designmaster0928/Bluetooth-Adapter-Project/K-cord_Pinouts.png

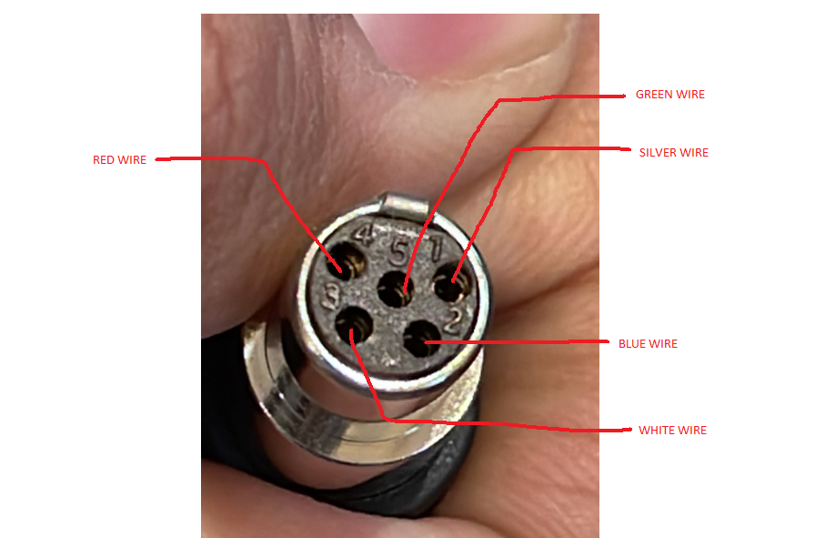
K-cord_Pinouts.png
