designmaster0928/Bluetooth-Adapter-Project/Photo/DA726437-B9D8-48D1-A68D-65F9451EB42A.jpg

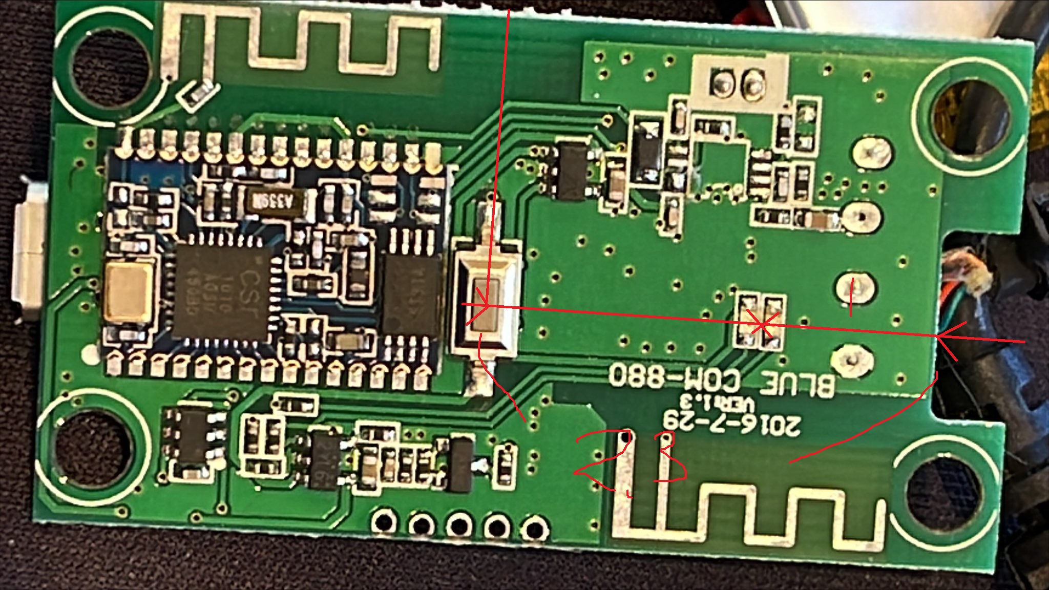
Photo/DA726437-B9D8-48D1-A68D-65F9451EB42A.jpg
