designmaster0928/Bluetooth-Adapter-Project/BLUETOOTH ADAPTER CASE-SW/Skype_Picture_2023_05_28T19_03_59_601Z.jpeg

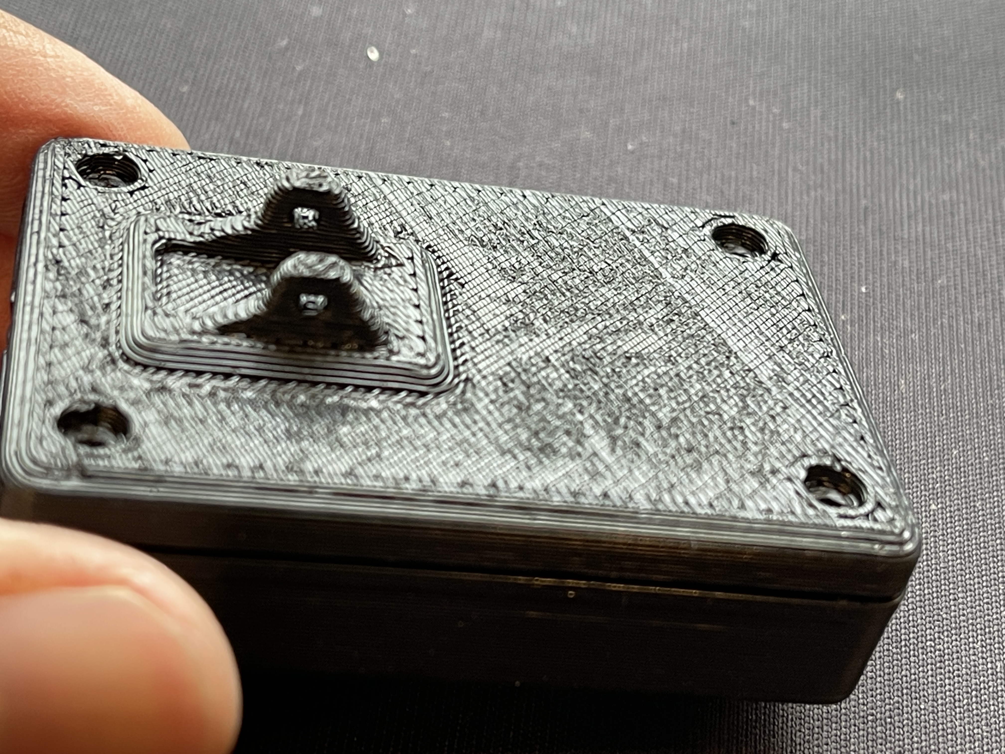
BLUETOOTH ADAPTER CASE-SW/Skype_Picture_2023_05_28T19_03_59_601Z.jpeg
