designmaster0928/Bluetooth-Adapter-Project/BLUETOOTH ADAPTER CASE-SW/Skype_Picture_2023_05_28T19_04_05_961Z.jpeg

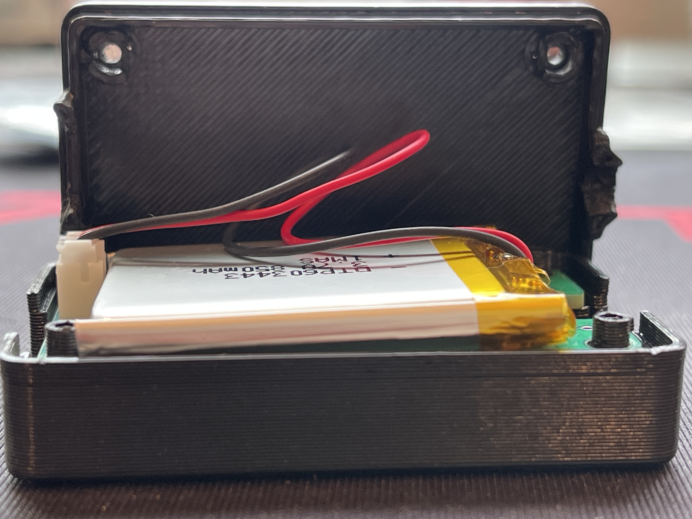
BLUETOOTH ADAPTER CASE-SW/Skype_Picture_2023_05_28T19_04_05_961Z.jpeg
