designmaster0928/Bluetooth-Adapter-Project/DC9E3603-5C23-4AAF-9660-845D350AA5AE.jpg

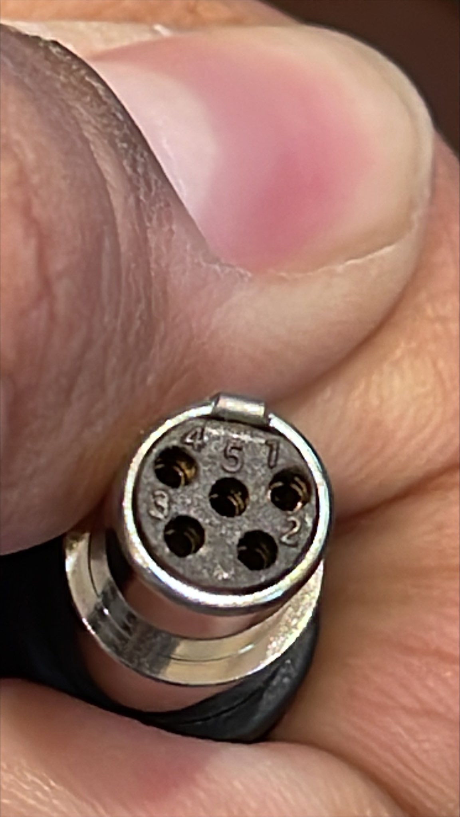
DC9E3603-5C23-4AAF-9660-845D350AA5AE.jpg
