designmaster0928/Bluetooth-Adapter-Project/Photo/6621D68A-7FBE-48DB-8DF5-E619D0314C2F.jpg

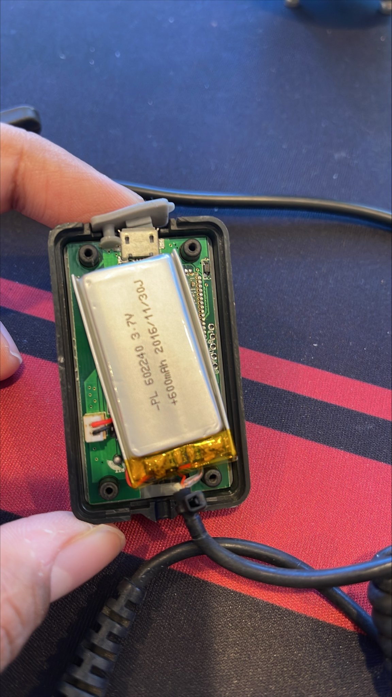
Photo/6621D68A-7FBE-48DB-8DF5-E619D0314C2F.jpg
