designmaster0928/Bluetooth-Adapter-Project/Photo/C3E56E78-954D-4BAD-87F1-18FE880F4F31.jpg

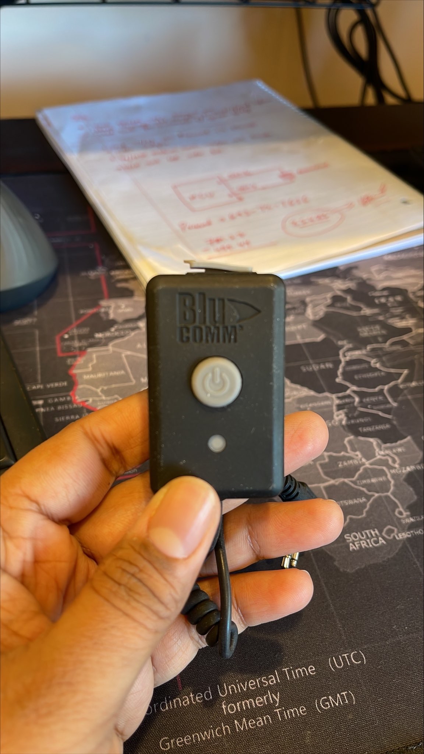
Photo/C3E56E78-954D-4BAD-87F1-18FE880F4F31.jpg
