designmaster0928/Bluetooth-Adapter-Project/Photo/C45BCC9A-C9F5-43B7-A155-E445F8E02B1C.jpg

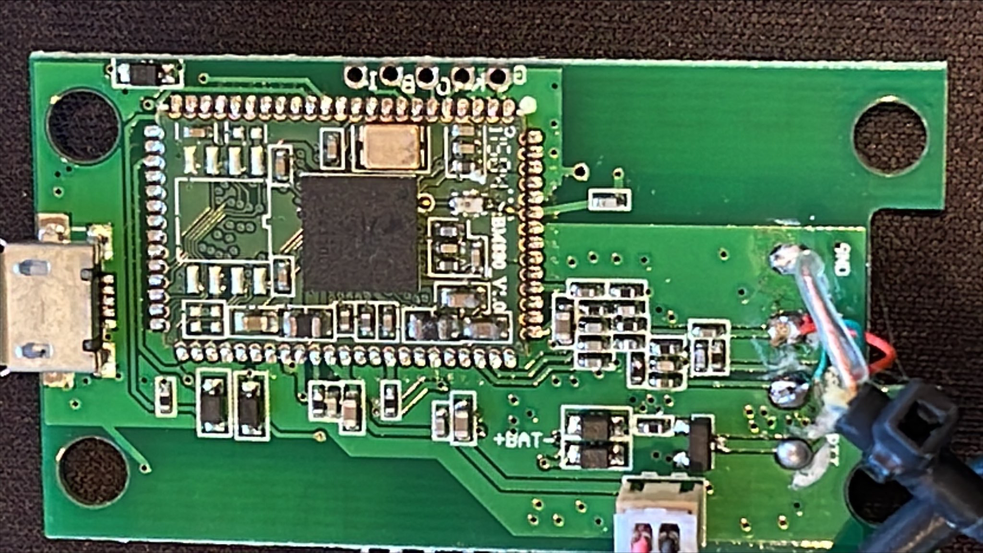
Photo/C45BCC9A-C9F5-43B7-A155-E445F8E02B1C.jpg
