designmaster0928/Bluetooth-Adapter-Project/Photo/C2696927-9B45-439D-AC03-30553FDB2B25.jpg

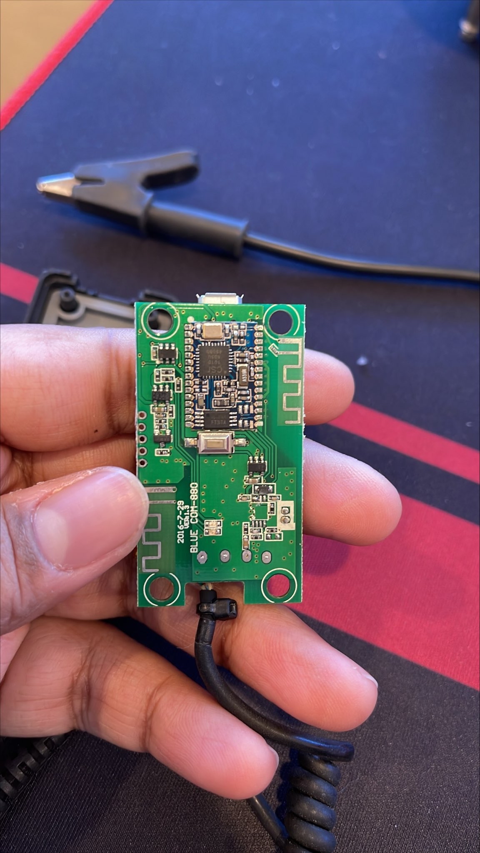
Photo/C2696927-9B45-439D-AC03-30553FDB2B25.jpg
