designmaster0928/Bluetooth-Adapter-Project/Photo/EB455BE9-71F3-468A-BE8D-6DA9E513DC0C.jpg

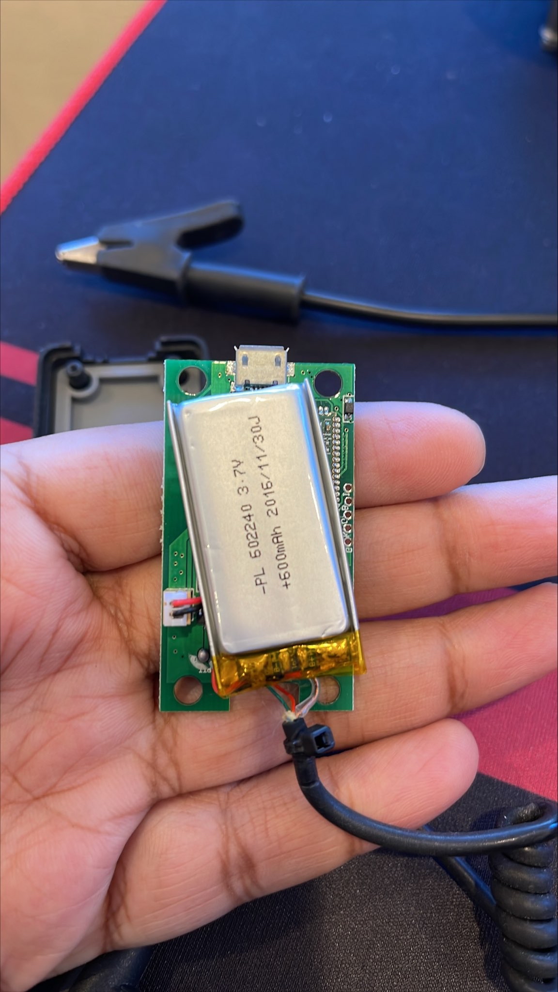
Photo/EB455BE9-71F3-468A-BE8D-6DA9E513DC0C.jpg
