designmaster0928/Bluetooth-Adapter-Project/Photo/image_2023_01_27T21_55_18_105Z.png

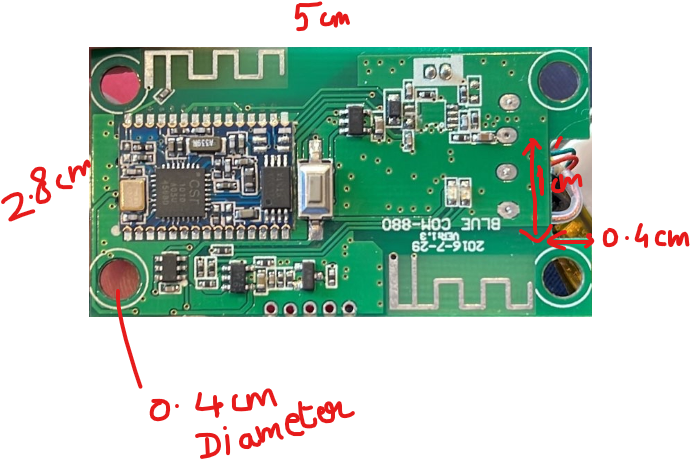
Photo/image_2023_01_27T21_55_18_105Z.png
