designmaster0928/Bluetooth-Adapter-Project/Photo/image_2023_01_27T21_58_32_056Z.png

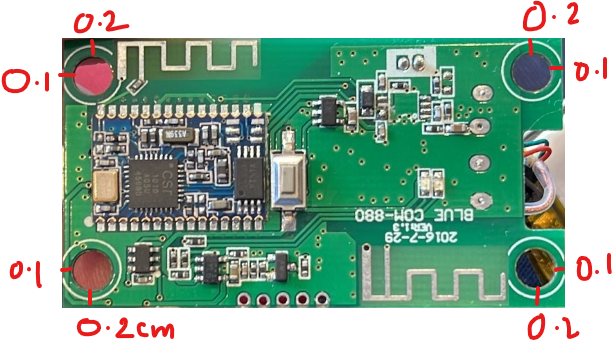
Photo/image_2023_01_27T21_58_32_056Z.png
