designmaster0928/Bluetooth-Adapter-Project/Photo/k-cord1.PNG

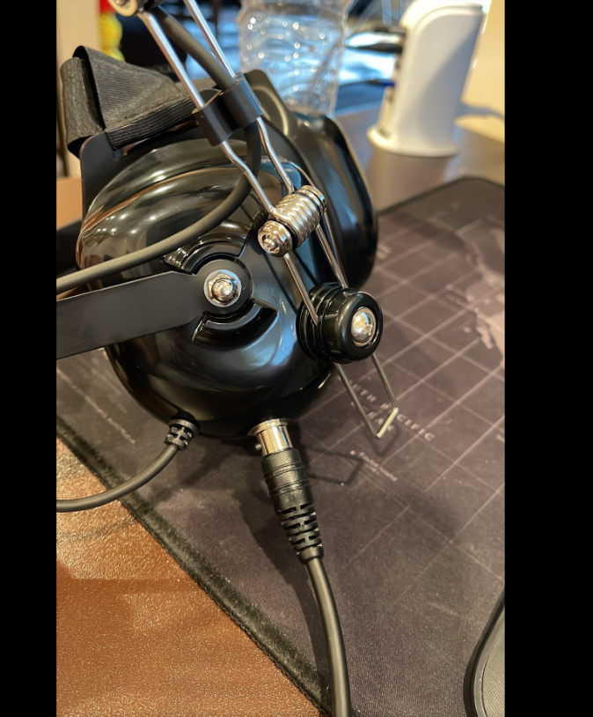
Photo/k-cord1.PNG
