designmaster0928/Bluetooth-Adapter-Project/Photo/k-cord2.PNG

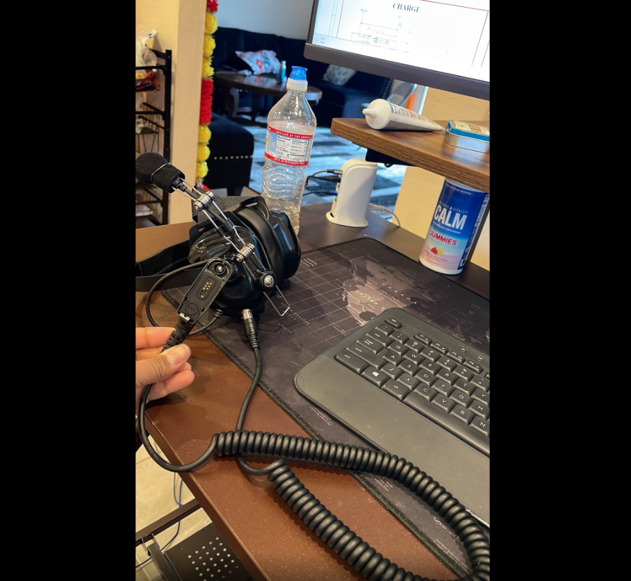
Photo/k-cord2.PNG
