designmaster0928/Bluetooth-Adapter-Project/Photo/k-cord-incablewire.PNG

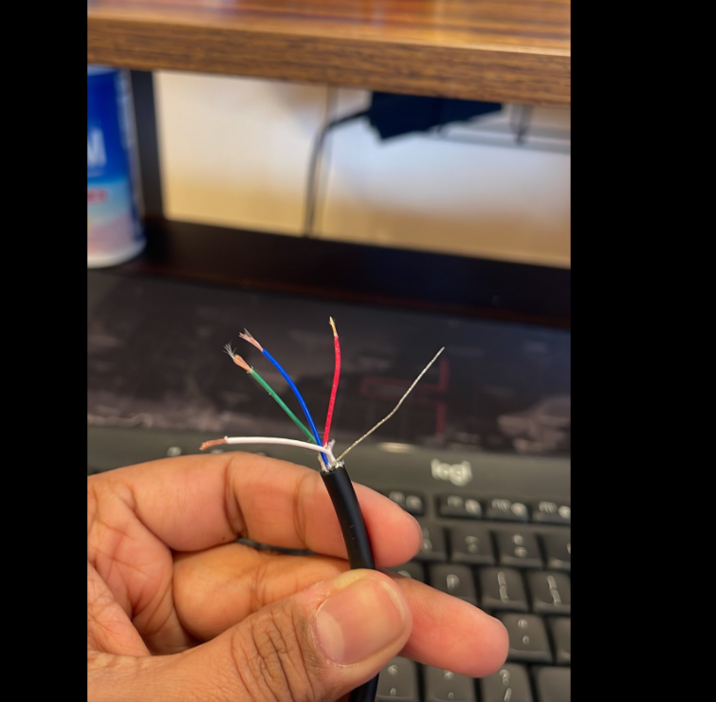
Photo/k-cord-incablewire.PNG
