designmaster0928/Bluetooth-Adapter-Project/Photo/k-cord_COn.PNG

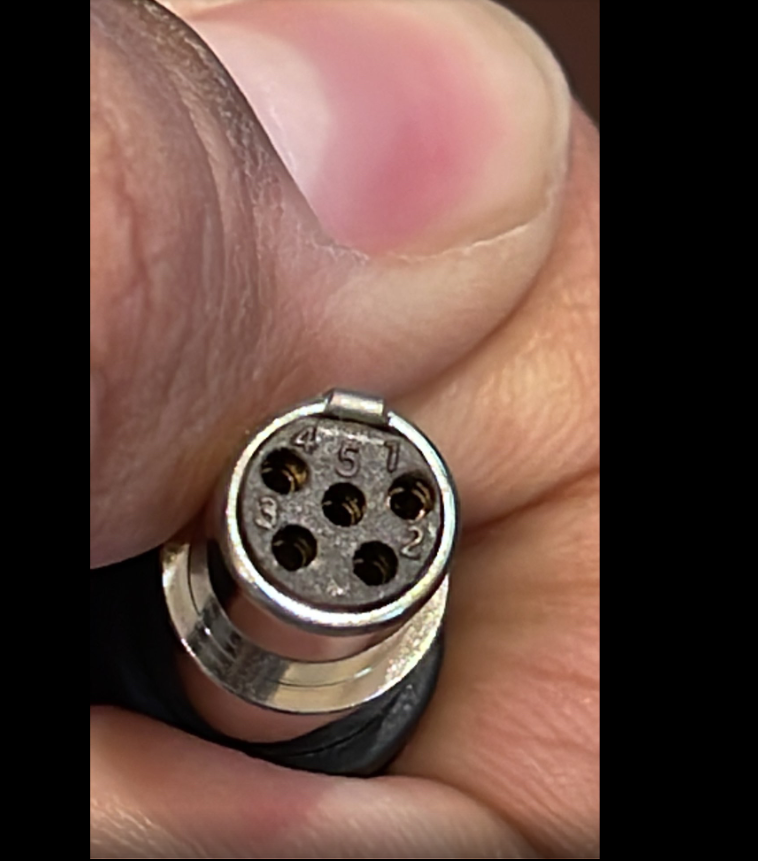
Photo/k-cord_COn.PNG
