designmaster0928/Bluetooth-Adapter-Project/Photo/Screenshot 2023-06-01 025503.png

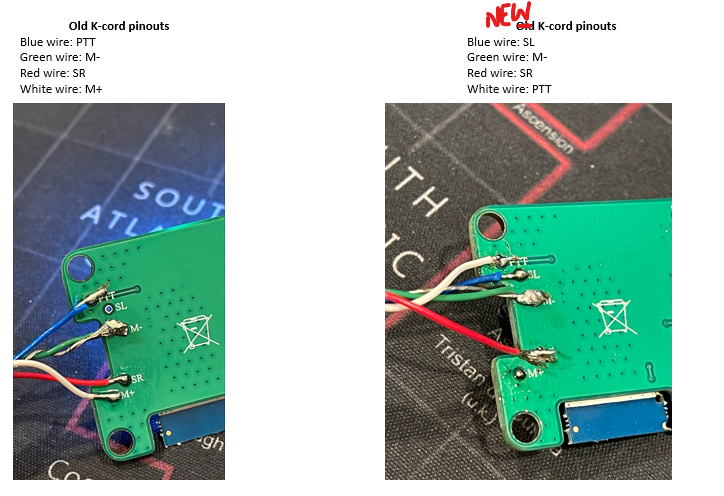
Photo/Screenshot 2023-06-01 025503.png
