designmaster0928/Bluetooth-Adapter-Project/Untitled.png

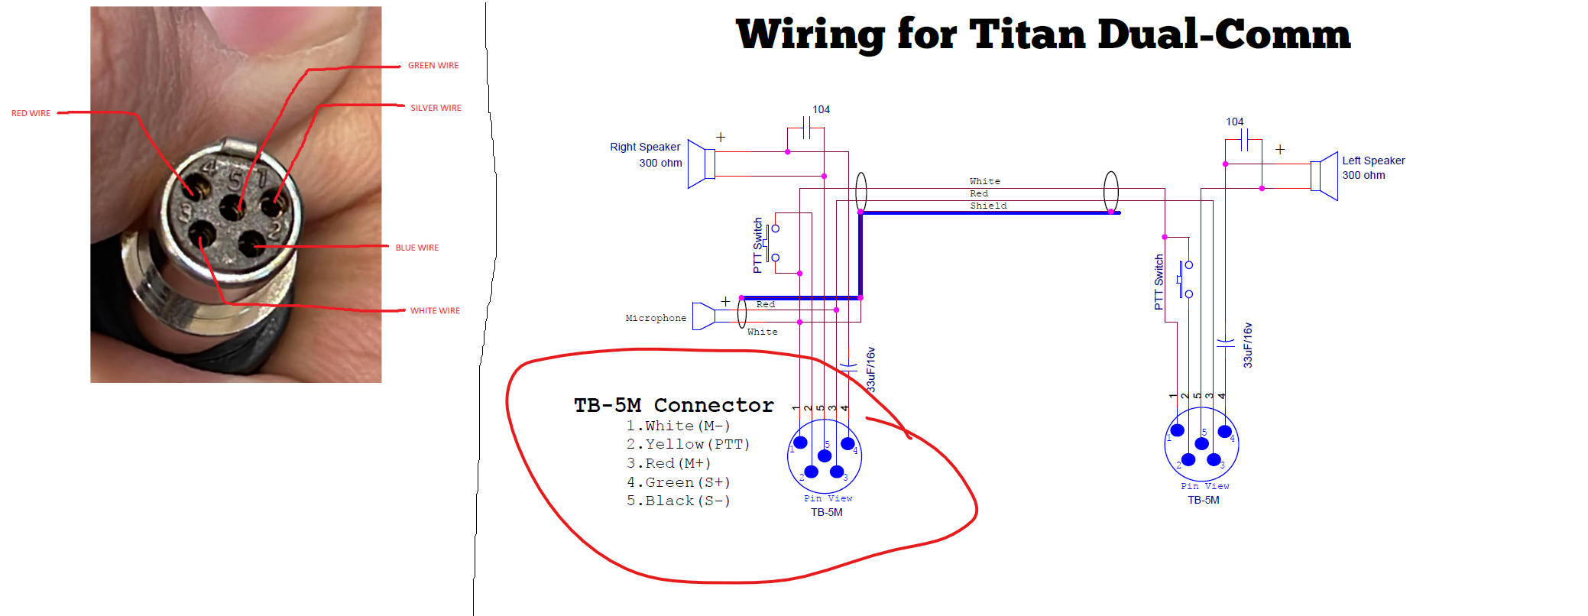
Untitled.png
