designmaster0928/Bluetooth-Adapter-Project/DXP/version4_LIPO/Production_files/BOM/BluetoothAdapter4.0.xlsx

Sheet: Part List Report
 |  | Bluetooth Adapter 4.0 |  |  |  |  |  |  | 15/8/2023
# | Value | Name | Designator | Description | Manufacturer | Manufacturer Product Number | Digi-Key Part Number | Digi-Key PurchaseURL | Quantity
1 | 10uF/16V | CAP CER 10UF 16V X5R 0603 | C1, C2, C11, C12, C13, C14, C15 | 10 µF ±20% 16V Ceramic Capacitor X5R 0603 (1608 Metric) | Murata Electronics | GRM188R61C106MAALD | 490-10729-6-ND | https://www.digikey.com/en/products/detail/murata-electronics/GRM188R61C106MAALD/4905340 | 7
2 | 0.1uF/25V | CAP CER 0.1UF 25V X7R 0603 | C3, C4, C5, C7, C8, C9, C10 | 0.1 µF ±10% 25V Ceramic Capacitor X7R 0603 (1608 Metric) | KEMET | C0603C104K3RAC7867 | 399-C0603C104K3RAC7867TR-ND | https://www.digikey.com/en/products/detail/kemet/C0603C104K3RAC7867/416044 | 7
3 | 100pF/25V | CAP CER 100PF 25V X7R 0603 | C6 | 0.1 µF ±10% 25V Ceramic Capacitor X7R 0603 (1608 Metric) | KEMET | C0603C101K3RACAUTO | 399-C0603C101K3RACAUTODKR-ND | https://www.digikey.com/en/products/detail/kemet/C0603C101K3RACAUTO/10642423 | 1
4 | SD0805S020S1R0 | DIODE SCHOTTKY 20V 1A 0805 | D1, D2, D3, D4 | Diode 20 V 1A Surface Mount 0805 (2012 Metric) | AVX | SD0805S020S1R0 | 581-SD0805S020S1R0 | https://www.mouser.co.uk/ProductDetail/AVX-Kyocera/SD0805S020S1R0?qs=jCA%252BPfw4LHbpkAoSnwrdjw%3D%3D | 4
5 | B38G3RGB-10D0003H2U1930 | LED RGB MIXED WHITE ( 1.6(L)X1.6 | D5 | Red, Green, Blue (RGB) LED Indication - Discrete 2V Red, 3V Green, 3V Blue 0606 (1616 Metric) | Harvatek Corporation | B38G3RGB-10D0003H2U1930 | 3147-B38G3RGB-10D0003H2U1930DKR-ND | https://www.digikey.com/en/products/detail/harvatek-corporation/B38G3RGB-10D0003H2U1930/13588733 | 1
6 | DFR0781 | AUDIO BLE/SPP PASS-THROUGH MODU | IC1 | Bluetooth Bluetooth v5.0 Transceiver Module Antenna Not Included Surface Mount | DFRobot | DFR0781 | 1738-DFR0781-ND | https://www.digikey.com/en/products/detail/dfrobot/DFR0781/13688344?s=N4IgTCBcDaICYDMBOAGA7ADgIwgLoF8g | 1
7 | ATTINY3217-MNR | IC MCU 8BIT 32KB FLASH 24VQFN | IC2 | AVR tinyAVR™ 1, Functional Safety (FuSa) Microcontroller IC 8-Bit 20MHz 32KB (32K x 8) FLASH 24-VQFN (4x4) | Microchip | ATTINY3217-MNR | ATTINY3217-MNRDKR-ND | https://www.digikey.com/en/products/detail/microchip-technology/ATTINY3217-MNR/9477738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 | 1
8 | USB4105-GF-A | CONN RCP USB2.0 TYP C 24P SMD RA | J1, J2 | USB-C (USB TYPE-C) USB 2.0 Receptacle Connector 24 (16+8 Dummy) Position Surface Mount, Right Angle; Through Hole | GCT | USB4105-GF-A | 2073-USB4105-GF-ADKR-ND | https://www.digikey.com/en/products/detail/gct/USB4105-GF-A/11198441 | 2
9 | B2B-PH-K-S(LF)(SN) | CONN HEADER VERT 2POS 2MM | J3 | Connector Header Through Hole 2 position 0.079" (2.00mm) | JST Sales America Inc. | B2B-PH-K-S(LF)(SN) | 455-1704-ND | https://www.digikey.com/en/products/detail/jst-sales-america-inc/B2B-PH-K-S-LF-SN/926611 | 1
10 | 4.7uH | FIXED IND 4.7UH 1.3A 120MOHM SMD | L1 | 4.7 µH Shielded Multilayer Inductor 1.3 A 120mOhm 1008 (2520 Metric) | Abracon LLC | AIML-1008HC-4R7M-T | 535-12797-6-ND | https://www.digikey.com/en/products/detail/abracon-llc/AIML-1008HC-4R7M-T/5043494 | 1
11 | S8050 | TRANS NPN 25V 0.5A SOT23 | Q1, Q3 | Bipolar (BJT) Transistor NPN 25 V 500 mA 150MHz 300 mW Surface Mount SOT-23 | MDD | S8050 | 3372-S8050TR-ND | https://www.digikey.com/en/products/detail/nextgen-components/S8050/16602420 | 2
12 | CPH6341-TL-W | MOSFET P-CH 30V 5A 6CPH | Q2 | P-Channel 30 V 5A (Ta) 1.6W (Ta) Surface Mount 6-CPH | onsemi | CPH6341-TL-W | CPH6341-TL-WOSDKR-ND | https://www.digikey.com/en/products/detail/onsemi/CPH6341-TL-W/4847611 | 1
13 | 10K | RES 10K OHM 1% 1/10W 0603 | R1, R4, R7, R8, R10, R11, R12, R13, R20 | 10 kOhms ±1% 0.1W, 1/10W Chip Resistor 0603 (1608 Metric) Moisture Resistant Thick Film | YAGEO | RC0603FR-0710KL | 311-10.0KHRCT-ND | https://www.digikey.com/en/products/detail/yageo/RC0603FR-0710KL/726880 | 9
14 | 100K | RES 100K OHM 1% 1/10W 0603 | R2 | 100 kOhms ±1% 0.1W, 1/10W Chip Resistor 0603 (1608 Metric) Moisture Resistant Thick Film | YAGEO | RC0603FR-07100KL | 311-100KHRDKR-ND | https://www.digikey.com/en/products/detail/yageo/RC0603FR-07100KL/726889 | 1
15 | 56R | RES 56 OHM 1% 1/10W 0603 | R3, R9 | 1 kOhms ±1% 0.1W, 1/10W Chip Resistor 0603 (1608 Metric) Moisture Resistant Thick Film | YAGEO | RC0603FR-0756RL | 311-56.0HRDKR-ND | https://www.digikey.com/en/products/detail/yageo/RC0603FR-0756RL/727301 | 2
16 | 1K | RES 1K OHM 1% 1/10W 0603 | R5, R14, R15, R16, R18, R21, R22, R23 | 1 kOhms ±1% 0.1W, 1/10W Chip Resistor 0603 (1608 Metric) Moisture Resistant Thick Film | YAGEO | RC0603FR-071KL | 311-1.00KHRTR-ND | https://www.digikey.com/en/products/detail/yageo/RC0603FR-071KL/726843 | 8
17 | 470R | RES 470 OHM 1% 1/10W 0603 | R6 | 470 Ohms ±1% 0.1W, 1/10W Chip Resistor 0603 (1608 Metric) Moisture Resistant Thick Film | YAGEO | RC0603FR-07470RL | 311-470HRDKR-ND | https://www.digikey.com/en/products/detail/yageo/RC0603FR-07470RL/727256 | 1
18 | 200R | RES 200 OHM 1% 1/10W 0603 | R17 | 10 kOhms ±1% 0.1W, 1/10W Chip Resistor 0603 (1608 Metric) Moisture Resistant Thick Film | YAGEO | RC0603FR-07200RL | 311-200HRDKR-ND | https://www.digikey.com/en/products/detail/yageo/RC0603FR-07200RL/727043 | 1
19 | 200K | RES 200K OHM 1% 1/10W 0603 | R19 | 200 kOhms ±1% 0.1W, 1/10W Chip Resistor 0603 (1608 Metric) Moisture Resistant Thick Film | YAGEO | RC0603FR-10200KL | 13-RC0603FR-10200KLDKR-ND | https://www.digikey.com/en/products/detail/yageo/RC0603FR-10200KL/14008344 | 1
20 | 22R | RES 22 OHM 5% 1/10W 0603 | R24, R25 | 22 Ohms ±5% 0.1W, 1/10W Chip Resistor 0603 (1608 Metric) Moisture Resistant Thick Film | YAGEO | RC0603JR-0722RL | 311-22GRDKR-ND | https://www.digikey.com/en/products/detail/yageo/RC0603JR-0722RL/726743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 | 2
21 | 0.4R | RES 0.4 OHM 1% 1/4W 1206 | R26 | 400 mOhms ±1% 0.25W, 1/4W Chip Resistor 1206 (3216 Metric) Automotive AEC-Q200, Current Sense, Moisture Resistant Thick Film | YAGEO | RL1206FR-070R4L | 311-.4LWDKR-ND | https://www.digikey.com/en/products/detail/yageo/RL1206FR-070R4L/3886028 | 1
22 | 6.2K | RES 6.2K OHM 1% 1/10W 0603 | R27 | 6.2 kOhms ±1% 0.1W, 1/10W Chip Resistor 0603 (1608 Metric) Moisture Resistant Thick Film | YAGEO | RC0603FR-076K2L | 311-6.20KHRDKR-ND | https://www.digikey.com/en/products/detail/yageo/RC0603FR-076K2L/727319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 | 1
23 | 2K | RES 2K OHM 1% 1/10W 0603 | R28, R29 | 2 kOhms ±1% 0.1W, 1/10W Chip Resistor 0603 (1608 Metric) Moisture Resistant Thick Film | YAGEO | RC0603FR-072KL | 311-2.00KHRDKR-ND | https://www.digikey.com/en/products/detail/yageo/RC0603FR-072KL/727009 | 2
24 | 5.1K | RES 5.1K OHM 1% 1/10W 0603 | R30 | 5.1kOhms ±1% 0.1W, 1/10W Chip Resistor 0603 (1608 Metric) Moisture Resistant Thick Film | YAGEO | RC0603FR-075K1L | 311-5.10KHRDKR-ND | https://www.digikey.com/en/products/detail/yageo/RC0603FR-075K1L/727268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 | 1
25 | 2.7K | RES 2.7K OHM 1% 1/10W 0603 | R31 | 2.7 kOhms ±1% 0.1W, 1/10W Chip Resistor 0603 (1608 Metric) Moisture Resistant Thick Film | YAGEO | RC0603FR-072K7L | 311-2.70KHRDKR-ND | https://www.digikey.com/en/products/detail/yageo/RC0603FR-072K7L/727032 | 1
26 | RS-282G05A3-SM RT | SWITCH TACTILE SPST-NO 0.05A 12V | S1 | Tactile Switch SPST-NO Top Actuated Surface Mount | C & K COMPONENTS | RS-282G05A3-SM RT | CKN10384DKR-ND | https://www.digikey.com/en/products/detail/c-k/RS-282G05A3-SM-RT/2747190 | 1
27 | MCP1642B-50I/MS | IC REG BOOST 5V 800MA 8MSOP | U1 | Boost Switching Regulator IC Positive Fixed 5V 1 Output 800mA 8-TSSOP, 8-MSOP (0.118", 3.00mm Width) | Microchip Technology | MCP1642B-50I/MS | MCP1642B-50I/MS-ND | https://www.digikey.com/en/products/detail/microchip-technology/MCP1642B-50I-MS/5137716 | 1
28 | CH340N | IC USB TO UART BRIDGE SOP-8 | U2 | IC USB TO UART BRIDGE SOP-8 | WCH(Jiangsu Qin Heng) | CH340N | C506813 | https://www.lcsc.com/product-detail/USB-ICs_WCH-Jiangsu-Qin-Heng-CH340N_C506813.html | 1
29 | TP4056 | ESOP-8 Battery Management ICs | U3 | Complete single cell Li-Ion battery with a constant current / constant voltage linear charger | TPOWER semiconductor Co.,LTD. | TP4056 | C382139 | https://www.lcsc.com/product-detail/Battery-Management-ICs_TPOWER-TP4056_C382139.html | 1
30
31
32
 | APPROVED

Sheet: Project Information
Project Full Path | E:\Workspace\Altium\A-Dropbox_Yugansh\Richard_Klein\BluetoothAdapter\DXP\BluetoothAdapter1.0.PrjPcb
Project Filename | BluetoothAdapter1.0.PrjPcb
Variant Name | None
Data-Source Filename | BluetoothAdapter1.0.BomDoc
Data-Source Full Path | E:\Workspace\Altium\A-Dropbox_Yugansh\Richard_Klein\BluetoothAdapter\DXP\BluetoothAdapter1.0.BomDoc
Title | Bill of Materials for BOM Document [BluetoothAdapter1.0.BomDoc]
Total Quantity | 70
Report Time | 6:59 AM
Report Date | 2/4/2023
Report Date & Tine | 2/4/2023 6:59 AM
Output Name | Bill of Materials
Output Type | BOM_PartType
Output Generator Name | BOM
Output Generator Description | Bill of Materials
