designmaster0928/Bluetooth-Adapter-Project/BluetoothAdapter1.0.xlsx

Sheet: Part List Report
 |  |  |  |  |  |  |  |  | 2023-04-02
# | Value | Name | Designator | Description | Manufacturer | Manufacturer Product Number | Digi-Key Part Number | Digi-Key PurchaseURL | Quantity
1 | 10uF/16V | CAP CER 10UF 16V X5R 0603 | C1, C2, C11, C12, C14, C15 | 10 µF ±20% 16V Ceramic Capacitor X5R 0603 (1608 Metric) | Murata Electronics | GRM188R61C106MAALD | 490-10729-6-ND | https://www.digikey.com/en/products/detail/murata-electronics/GRM188R61C106MAALD/4905340 | 6
2 | 0.1uF/25V | CAP CER 0.1UF 25V X7R 0603 | C3, C4, C5, C7, C9, C10 | 0.1 µF ±10% 25V Ceramic Capacitor X7R 0603 (1608 Metric) | KEMET | C0603C104K3RAC7867 | 399-C0603C104K3RAC7867TR-ND | https://www.digikey.com/en/products/detail/kemet/C0603C104K3RAC7867/416044 | 6
3 | 1uF/25V | CAP CER 1UF 25V X7R 0603 | C6, C13 | 1 µF ±10% 25V Ceramic Capacitor X7R 0603 (1608 Metric) | KEMET | C0603C105K3RAC7867 | 399-C0603C105K3RAC7867DKR-ND | https://www.digikey.com/en/products/detail/kemet/C0603C105K3RAC7867/3317582 | 2
4 | 100pF/25V | CAP CER 100PF 25V X7R 0603 | C8 | 0.1 µF ±10% 25V Ceramic Capacitor X7R 0603 (1608 Metric) | KEMET | C0603C101K3RACAUTO | 399-C0603C101K3RACAUTODKR-ND | https://www.digikey.com/en/products/detail/kemet/C0603C101K3RACAUTO/10642423 | 1
5 | LL4148 | DIODE GEN PURP 100V 200MA SOD80 | D1, D2 | Diode Standard 100 V 200mA Surface Mount SOD-80 | onsemi | LL4148 | LL4148FSCT-ND | https://www.digikey.com/en/products/detail/onsemi/LL4148/1923046 | 2
6 | B38G3RGB-10D0003H2U1930 | LED RGB MIXED WHITE ( 1.6(L)X1.6 | D3 | Red, Green, Blue (RGB) LED Indication - Discrete 2V Red, 3V Green, 3V Blue 0606 (1616 Metric) | Harvatek Corporation | B38G3RGB-10D0003H2U1930 | 3147-B38G3RGB-10D0003H2U1930DKR-ND | https://www.digikey.com/en/products/detail/harvatek-corporation/B38G3RGB-10D0003H2U1930/13588733 | 1
7 | DFR0781 | AUDIO BLE/SPP PASS-THROUGH MODU | IC1 | Bluetooth Bluetooth v5.0 Transceiver Module Antenna Not Included Surface Mount | DFRobot | DFR0781 | 1738-DFR0781-ND | https://www.digikey.com/en/products/detail/dfrobot/DFR0781/13688344?s=N4IgTCBcDaICYDMBOAGA7ADgIwgLoF8g | 1
8 | ATTINY3217-MNR | IC MCU 8BIT 32KB FLASH 24VQFN | IC2 | AVR tinyAVR™ 1, Functional Safety (FuSa) Microcontroller IC 8-Bit 20MHz 32KB (32K x 8) FLASH 24-VQFN (4x4) | Microchip | ATTINY3217-MNR | ATTINY3217-MNRDKR-ND | https://www.digikey.com/en/products/detail/microchip-technology/ATTINY3217-MNR/9477738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 | 1
9 | 10118192-0001LF | CONN RCPT USB2.0 MICRO B SMD R/A | J2 | USB - micro B USB 2.0 Receptacle Connector 5 Position Surface Mount, Right Angle | Amphenol | 10118192-0001LF | 609-4613-6-ND | https://www.digikey.com/en/products/detail/amphenol-cs-fci/10118192-0001LF/2785387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 | 1
10 | B2B-ZR(LF)(SN) | CONN HEADER VERT 2POS 1.5MM | J3 | Connector Header Through Hole 2 position 0.059" (1.50mm) | JST (JAPAN SOLDERLESS TERMINALS) | B2B-ZR(LF)(SN) | 455-1657-ND | https://www.digikey.com/en/products/detail/jst-sales-america-inc/B2B-ZR-LF-SN/926564 | 1
11 | 4.7uH | FIXED IND 4.7UH 1.3A 120MOHM SMD | L1 | 4.7 µH Shielded Multilayer Inductor 1.3 A 120mOhm 1008 (2520 Metric) | Abracon LLC | AIML-1008HC-4R7M-T | 535-12797-6-ND | https://www.digikey.com/en/products/detail/abracon-llc/AIML-1008HC-4R7M-T/5043494 | 1
12 | S8050 | TRANS NPN 25V 0.5A SOT23 | Q1, Q3, Q4 | Bipolar (BJT) Transistor NPN 25 V 500 mA 150MHz 300 mW Surface Mount SOT-23 | MDD | S8050 | 3372-S8050TR-ND | https://www.digikey.com/en/products/detail/nextgen-components/S8050/16602420 | 3
13 | CPH6341-TL-W | MOSFET P-CH 30V 5A 6CPH | Q2 | P-Channel 30 V 5A (Ta) 1.6W (Ta) Surface Mount 6-CPH | onsemi | CPH6341-TL-W | CPH6341-TL-WOSDKR-ND | https://www.digikey.com/en/products/detail/onsemi/CPH6341-TL-W/4847611 | 1
14 | 10K | RES 10K OHM 1% 1/10W 0603 | R1, R7, R9, R10, R13, R14, R15, R19, R23 | 10 kOhms ±1% 0.1W, 1/10W Chip Resistor 0603 (1608 Metric) Moisture Resistant Thick Film | YAGEO | RC0603FR-0710KL | 311-10.0KHRCT-ND | https://www.digikey.com/en/products/detail/yageo/RC0603FR-0710KL/726880 | 9
15 | 22K | RES 22K OHM 1% 1/10W 0603 | R2 | 22 kOhms ±1% 0.1W, 1/10W Chip Resistor 0603 (1608 Metric) Moisture Resistant Thick Film | YAGEO | RC0603FR-0722KL | 311-22.0KHRDKR-ND | https://www.digikey.com/en/products/detail/yageo/RC0603FR-0722KL/727056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 | 1
16 | 0R_DNP | RES 0OHM 1% 1/10W 0603 | R3 | 0Ohms ±1% 0.1W, 1/10W Chip Resistor 0603 (1608 Metric) Moisture Resistant Thick Film | YAGEO | RC0603JR-070RL | 311-0.0GRDKR-ND | https://www.digikey.com/en/products/detail/yageo/RC0603JR-070RL/726675 | 1
17 | 100K | RES 100K OHM 1% 1/10W 0603 | R4 | 100 kOhms ±1% 0.1W, 1/10W Chip Resistor 0603 (1608 Metric) Moisture Resistant Thick Film | YAGEO | RC0603FR-07100KL | 311-100KHRDKR-ND | https://www.digikey.com/en/products/detail/yageo/RC0603FR-07100KL/726889 | 1
18 | 0R | RES 0OHM 1% 1/10W 0603 | R5, R30 | 0Ohms ±1% 0.1W, 1/10W Chip Resistor 0603 (1608 Metric) Moisture Resistant Thick Film | YAGEO | RC0603JR-070RL | 311-0.0GRDKR-ND | https://www.digikey.com/en/products/detail/yageo/RC0603JR-070RL/726675 | 2
19 | 56R | RES 56 OHM 1% 1/10W 0603 | R6, R11 | 1 kOhms ±1% 0.1W, 1/10W Chip Resistor 0603 (1608 Metric) Moisture Resistant Thick Film | YAGEO | RC0603FR-0756RL | 311-56.0HRDKR-ND | https://www.digikey.com/en/products/detail/yageo/RC0603FR-0756RL/727301 | 2
20 | 470R | RES 470 OHM 1% 1/10W 0603 | R8 | 470 Ohms ±1% 0.1W, 1/10W Chip Resistor 0603 (1608 Metric) Moisture Resistant Thick Film | YAGEO | RC0603FR-07470RL | 311-470HRDKR-ND | https://www.digikey.com/en/products/detail/yageo/RC0603FR-07470RL/727256 | 1
21 | 1K | RES 1K OHM 1% 1/10W 0603 | R12, R16, R17, R18, R21, R24, R25, R26 | 1 kOhms ±1% 0.1W, 1/10W Chip Resistor 0603 (1608 Metric) Moisture Resistant Thick Film | YAGEO | RC0603FR-071KL | 311-1.00KHRTR-ND | https://www.digikey.com/en/products/detail/yageo/RC0603FR-071KL/726843 | 8
22 | 200R | RES 200 OHM 1% 1/10W 0603 | R20 | 10 kOhms ±1% 0.1W, 1/10W Chip Resistor 0603 (1608 Metric) Moisture Resistant Thick Film | YAGEO | RC0603FR-07200RL | 311-200HRDKR-ND | https://www.digikey.com/en/products/detail/yageo/RC0603FR-07200RL/727043 | 1
23 | 200K | RES 200K OHM 1% 1/10W 0603 | R22 | 100 kOhms ±1% 0.1W, 1/10W Chip Resistor 0603 (1608 Metric) Moisture Resistant Thick Film | YAGEO | RC0603FR-10200KL | 13-RC0603FR-10200KLDKR-ND | https://www.digikey.com/en/products/detail/yageo/RC0603FR-10200KL/14008344 | 1
24 | 22R | RES 22 OHM 5% 1/10W 0603 | R27, R28 | 22 Ohms ±5% 0.1W, 1/10W Chip Resistor 0603 (1608 Metric) Moisture Resistant Thick Film | YAGEO | RC0603JR-0722RL | 311-22GRDKR-ND | https://www.digikey.com/en/products/detail/yageo/RC0603JR-0722RL/726743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 | 2
25 | 0.4R | RES 0.4 OHM 1% 1/4W 1206 | R29 | 400 mOhms ±1% 0.25W, 1/4W Chip Resistor 1206 (3216 Metric) Automotive AEC-Q200, Current Sense, Moisture Resistant Thick Film | YAGEO | RL1206FR-070R4L | 311-.4LWDKR-ND | https://www.digikey.com/en/products/detail/yageo/RL1206FR-070R4L/3886028 | 1
26 | 6.2K | RES 6.2K OHM 1% 1/10W 0603 | R31 | 6.2 kOhms ±1% 0.1W, 1/10W Chip Resistor 0603 (1608 Metric) Moisture Resistant Thick Film | YAGEO | RC0603FR-076K2L | 311-6.20KHRDKR-ND | https://www.digikey.com/en/products/detail/yageo/RC0603FR-076K2L/727319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 | 1
27 | 2K | RES 2K OHM 1% 1/10W 0603 | R32, R33 | 2 kOhms ±1% 0.1W, 1/10W Chip Resistor 0603 (1608 Metric) Moisture Resistant Thick Film | YAGEO | RC0603FR-072KL | 311-2.00KHRDKR-ND | https://www.digikey.com/en/products/detail/yageo/RC0603FR-072KL/727009 | 2
28 | 2.7K | RES 2.7K OHM 1% 1/10W 0603 | R34 | 2.7 kOhms ±1% 0.1W, 1/10W Chip Resistor 0603 (1608 Metric) Moisture Resistant Thick Film | YAGEO | RC0603FR-072K7L | 311-2.70KHRDKR-ND | https://www.digikey.com/en/products/detail/yageo/RC0603FR-072K7L/727032 | 1
29 | RS-282G05A3-SM RT | SWITCH TACTILE SPST-NO 0.05A 12V | S1 | Tactile Switch SPST-NO Top Actuated Surface Mount | C & K COMPONENTS | RS-282G05A3-SM RT | CKN10384DKR-ND | https://www.digikey.com/en/products/detail/c-k/RS-282G05A3-SM-RT/2747190 | 1
30 | MCP1642B-50I/MS | IC REG BOOST 5V 800MA 8MSOP | U1 | Boost Switching Regulator IC Positive Fixed 5V 1 Output 800mA 8-TSSOP, 8-MSOP (0.118", 3.00mm Width) | Microchip Technology | MCP1642B-50I/MS | MCP1642B-50I/MS-ND | https://www.digikey.com/en/products/detail/microchip-technology/MCP1642B-50I-MS/5137716 | 1
31 | TP4056 | ESOP-8 Battery Management ICs | U2 | Complete single cell Li-Ion battery with a constant current / constant voltage linear charger | TPOWER semiconductor Co.,LTD. | TP4056 | C382139 |  | 1
 | APPROVED

Sheet: Project Information
Project Full Path | E:\Workspace\Altium\A-Dropbox_Yugansh\Richard_Klein\BluetoothAdapter\DXP\BluetoothAdapter1.0.PrjPcb
Project Filename | BluetoothAdapter1.0.PrjPcb
Variant Name | None
Data-Source Filename | BluetoothAdapter1.0.BomDoc
Data-Source Full Path | E:\Workspace\Altium\A-Dropbox_Yugansh\Richard_Klein\BluetoothAdapter\DXP\BluetoothAdapter1.0.BomDoc
Title | Bill of Materials for BOM Document [BluetoothAdapter1.0.BomDoc]
Total Quantity | 70
Report Time | 6:59 AM
Report Date | 2/4/2023
Report Date & Tine | 2/4/2023 6:59 AM
Output Name | Bill of Materials
Output Type | BOM_PartType
Output Generator Name | BOM
Output Generator Description | Bill of Materials
