designmaster0928/Bluetooth-Adapter-Project/BLUETOOTH ADAPTER CASE-SW/CLIP.STEP

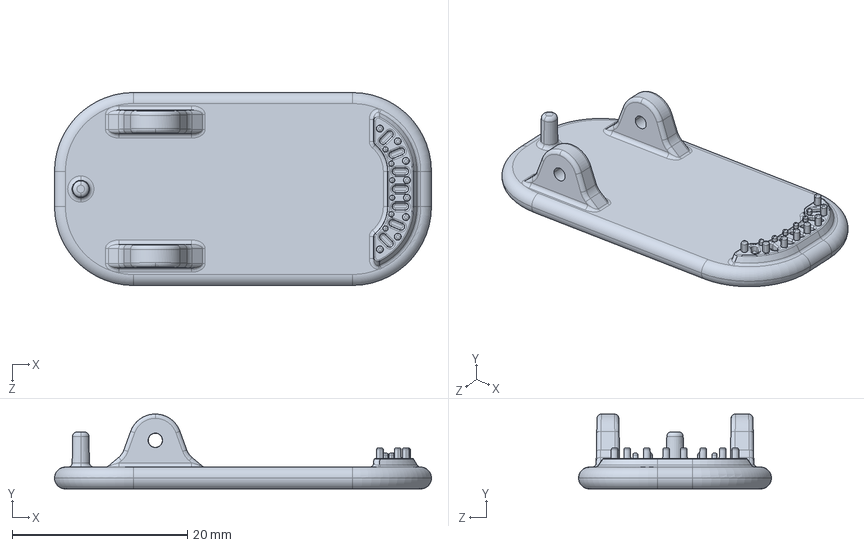
[picture p23: CAD file, 2023-11-19]
BLUETOOTH ADAPTER CASE-SW/CLIP.STEP
43.0 x 8.55 x 22.0 mm
