designmaster0928/Bluetooth-Adapter-Project/HOUSING BOTTOM.STEP

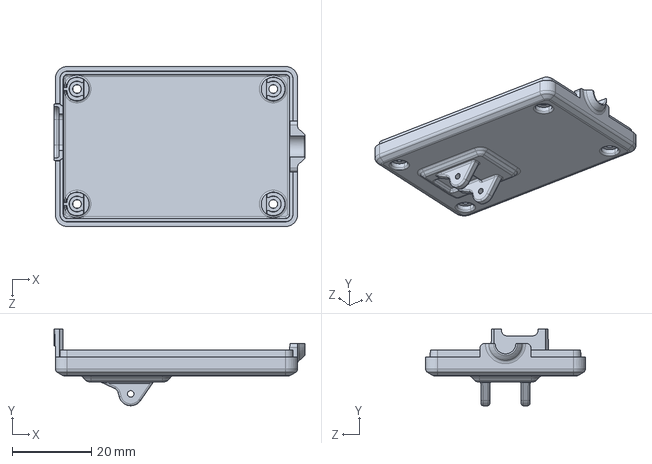
[picture p24: CAD file, 2023-11-19]
HOUSING BOTTOM.STEP
63.3 x 19.3 x 40.3 mm
