designmaster0928/Bluetooth-Adapter-Project/BLUETOOTH ADAPTER CASE-SW/LFB012CTP.STEP

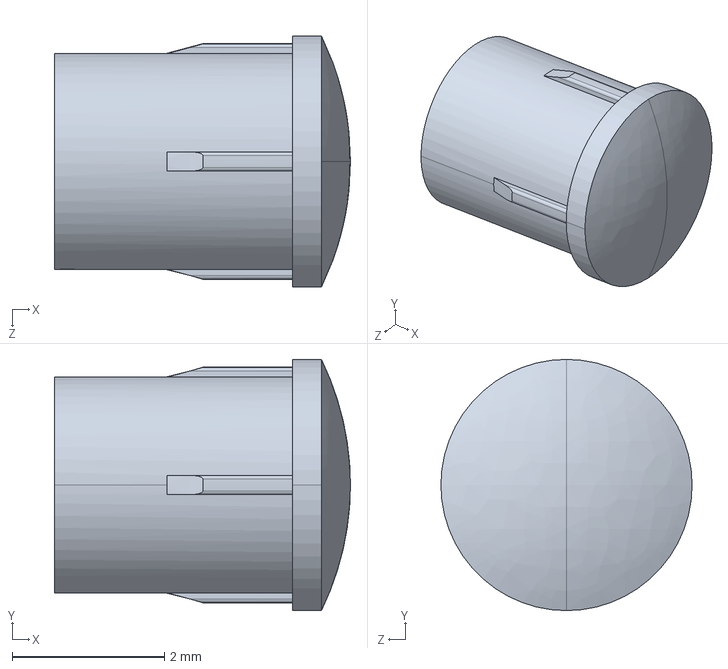
[picture p25: CAD file, 2023-11-19]
BLUETOOTH ADAPTER CASE-SW/LFB012CTP.STEP
3.89 x 3.30 x 3.30 mm
