designmaster0928/Bluetooth-Adapter-Project/BLUETOOTH ADAPTER CASE-SW/PIN.STEP

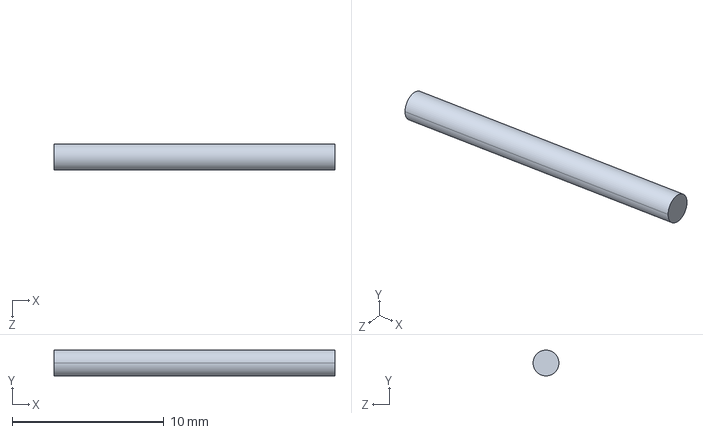
[picture p26: CAD file, 2023-11-19]
BLUETOOTH ADAPTER CASE-SW/PIN.STEP
18.5 x 1.70 x 1.70 mm
