designmaster0928/Bluetooth-Adapter-Project/BUTTON MEMBRANE.STEP

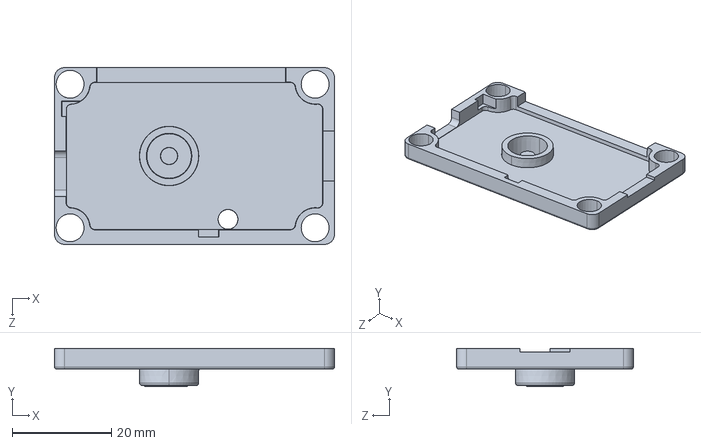
[picture p27: CAD file, 2023-11-19]
BUTTON MEMBRANE.STEP
56.6 x 7.70 x 35.7 mm
