designmaster0928/Bluetooth-Adapter-Project/HOUSING TOP.STEP

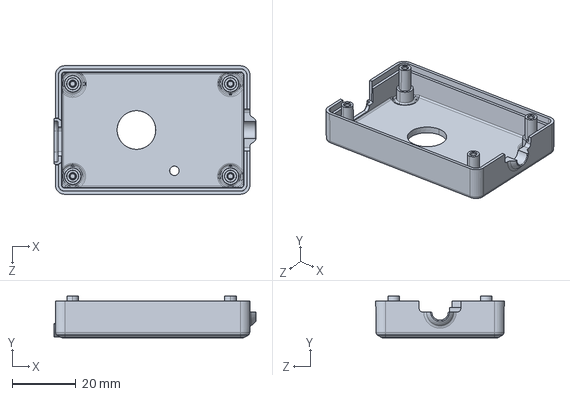
[picture p28: CAD file, 2023-11-19]
HOUSING TOP.STEP
63.4 x 13.1 x 40.3 mm
