designmaster0928/Bluetooth-Adapter-Project/BLUETOOTH ADAPTER CASE-SW/TORSION SPRING.STEP

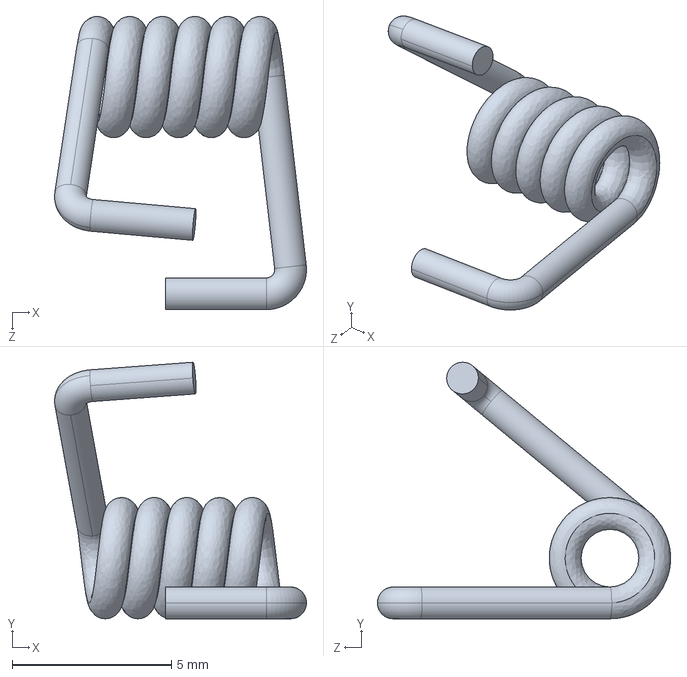
[picture p29: CAD file, 2023-11-19]
BLUETOOTH ADAPTER CASE-SW/TORSION SPRING.STEP
7.92 x 8.06 x 9.22 mm
