designmaster0928/Bluetooth-Adapter-Project/WIRING Titan Dual-Comm.pdf

+

# Wiring for Titan Dual-Comm

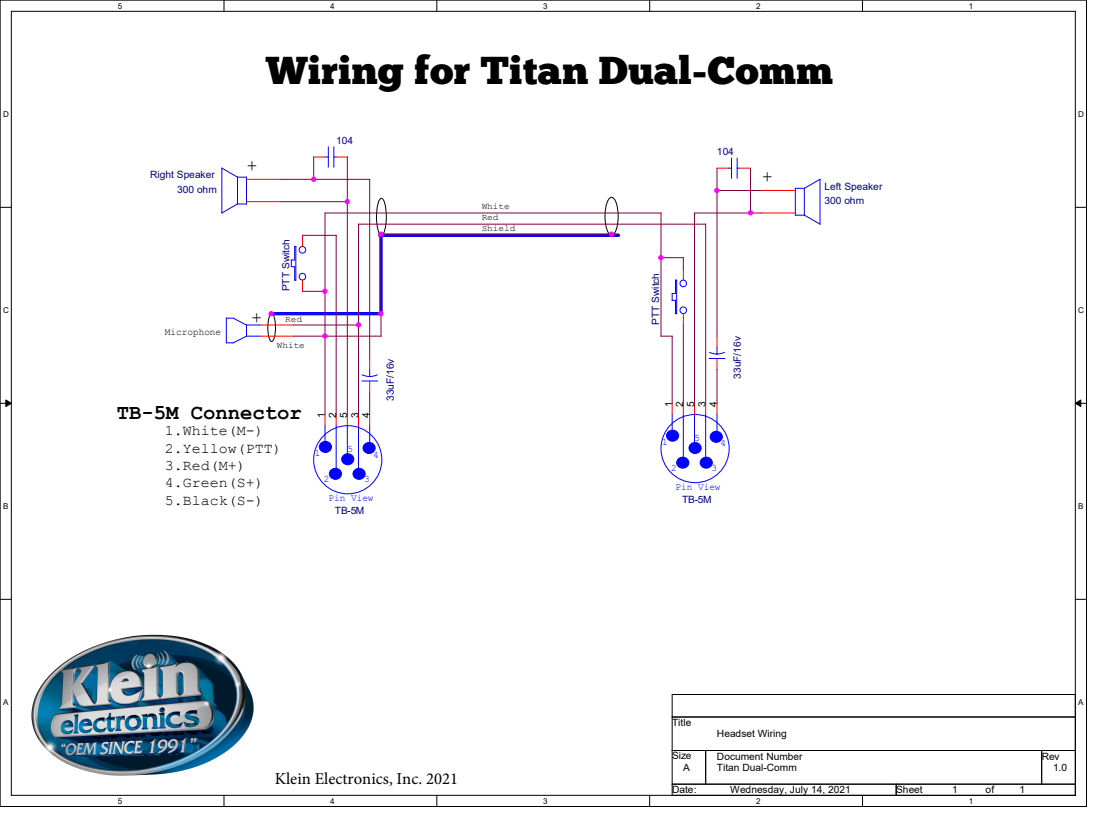
[picture p31: page 1]
Shield; Red; TB-5M Connector 1.White(M-) 2.Yellow(PTT) 3.Red(M+) 4.Green(S+) 5.Black(S-); White Red; Microphone; White; Headset Wiring; Title Size; Document Number; 300 ohm; Right Speaker; Left Speaker; 4 33uF/16v PTT Switch; 4 104 PTT Switch 33uF/16v

Pin View TB-5M

A | Titan Dual-Comm | Rev 1.0

Klein Electronics, Inc. 2021

Date: Wednesday, July 14, 2021 | Sheet 1 of 1
