designmaster0928/Bluetooth-Adapter-Project/Dwf.pdf

# 3.00mm 4.00mm

# 1.37mm7.86mm 7.40mm

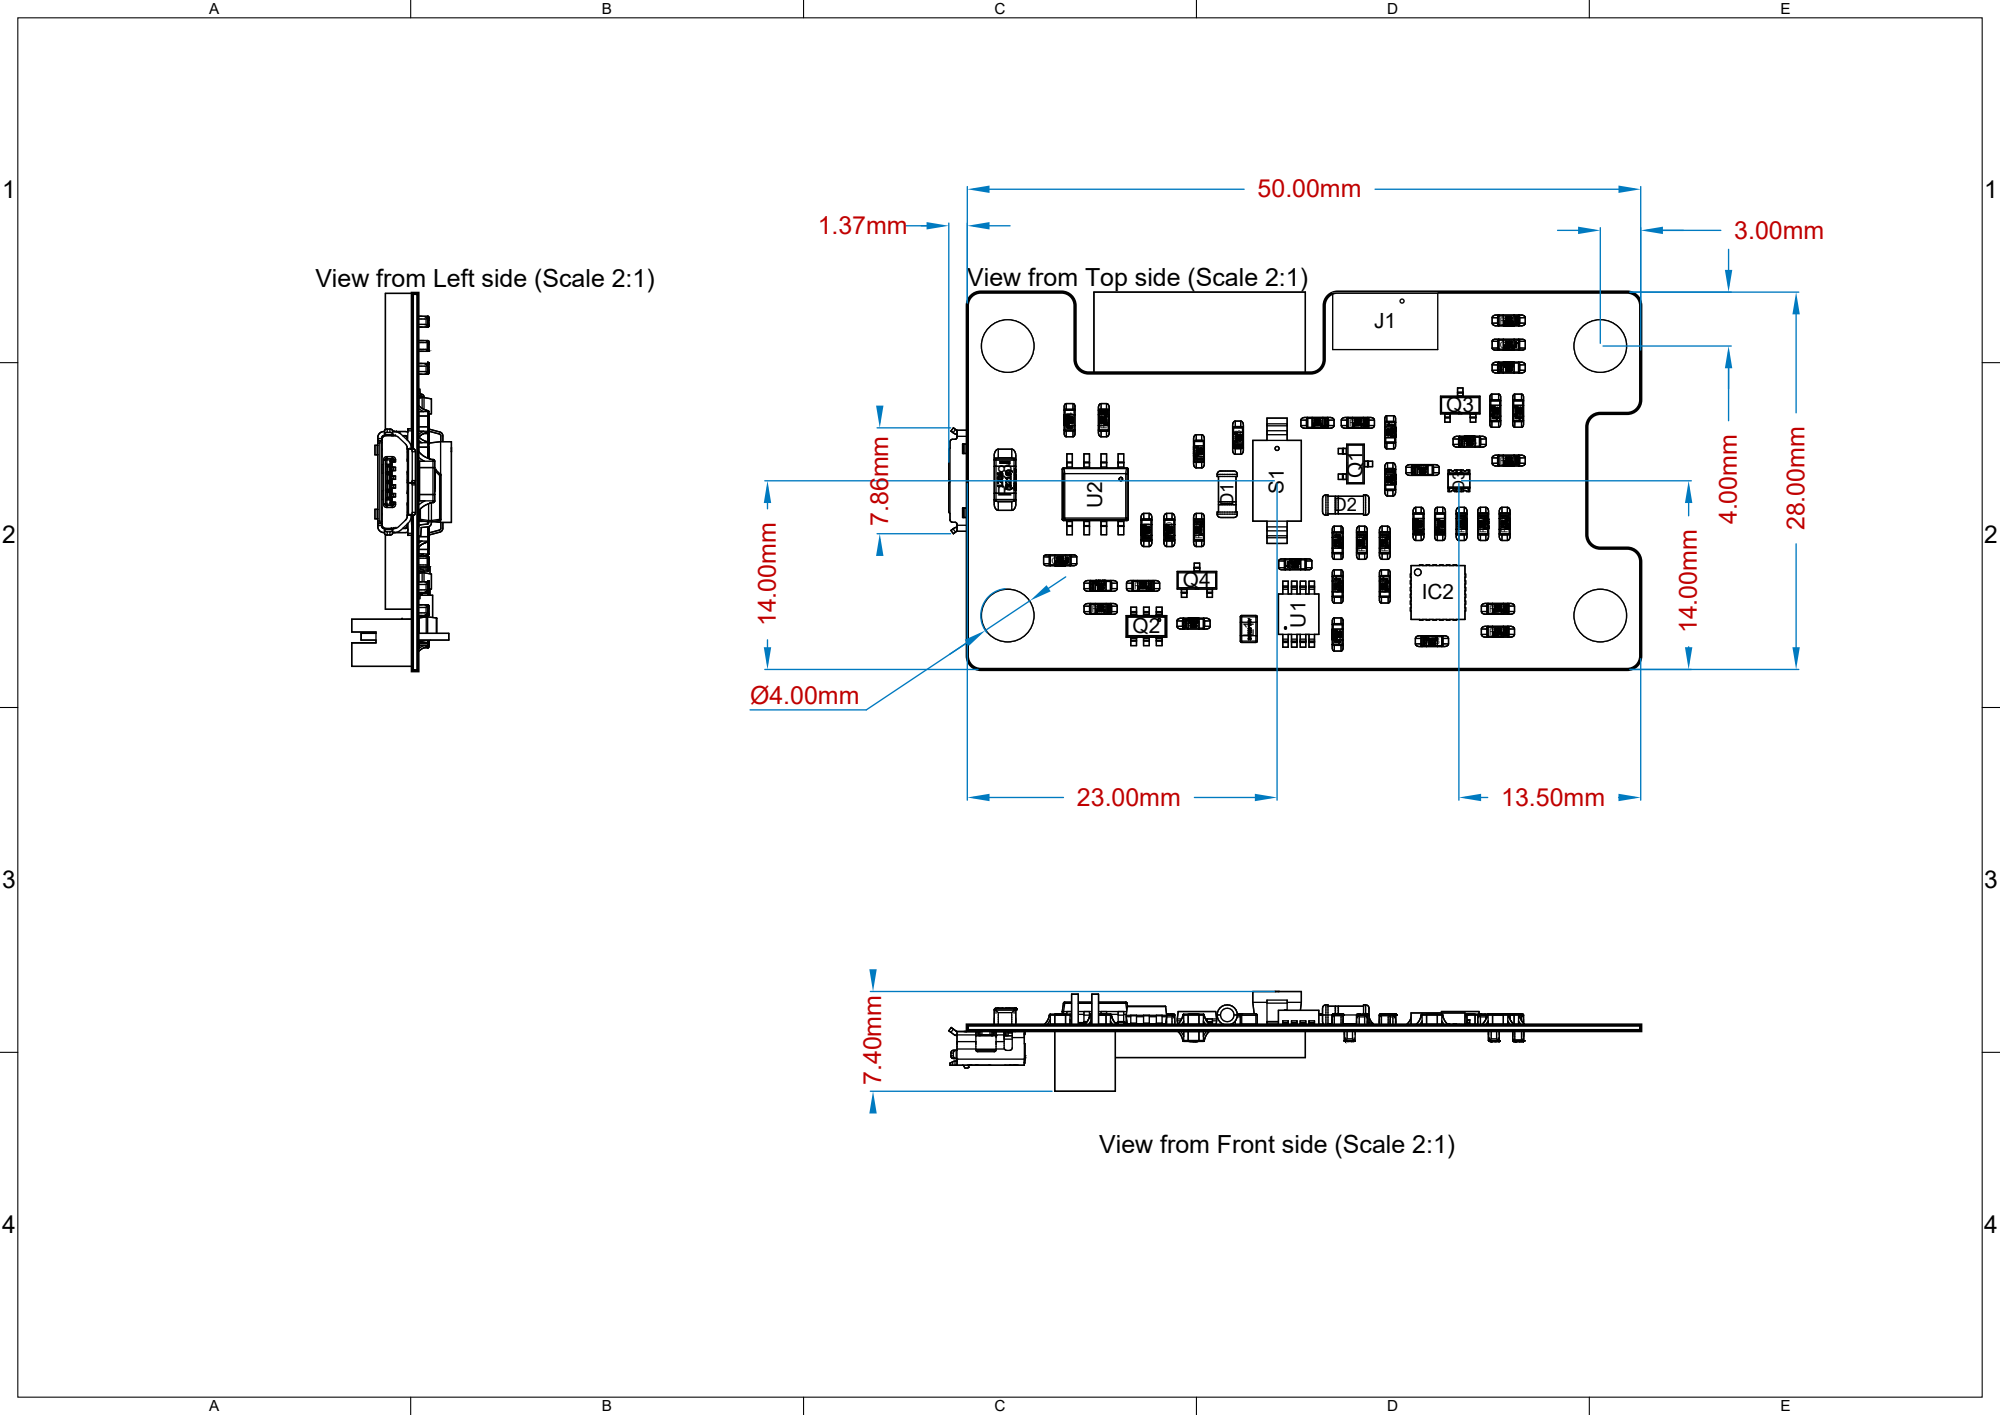
[picture p32: page 1]

View from Left side (Scale 2:1)

View from Top side (Scale 2:1)

View from Front side (Scale 2:1)
