designmaster0928/Bluetooth-Adapter-Project/BluetoothAdapter1.0.pdf

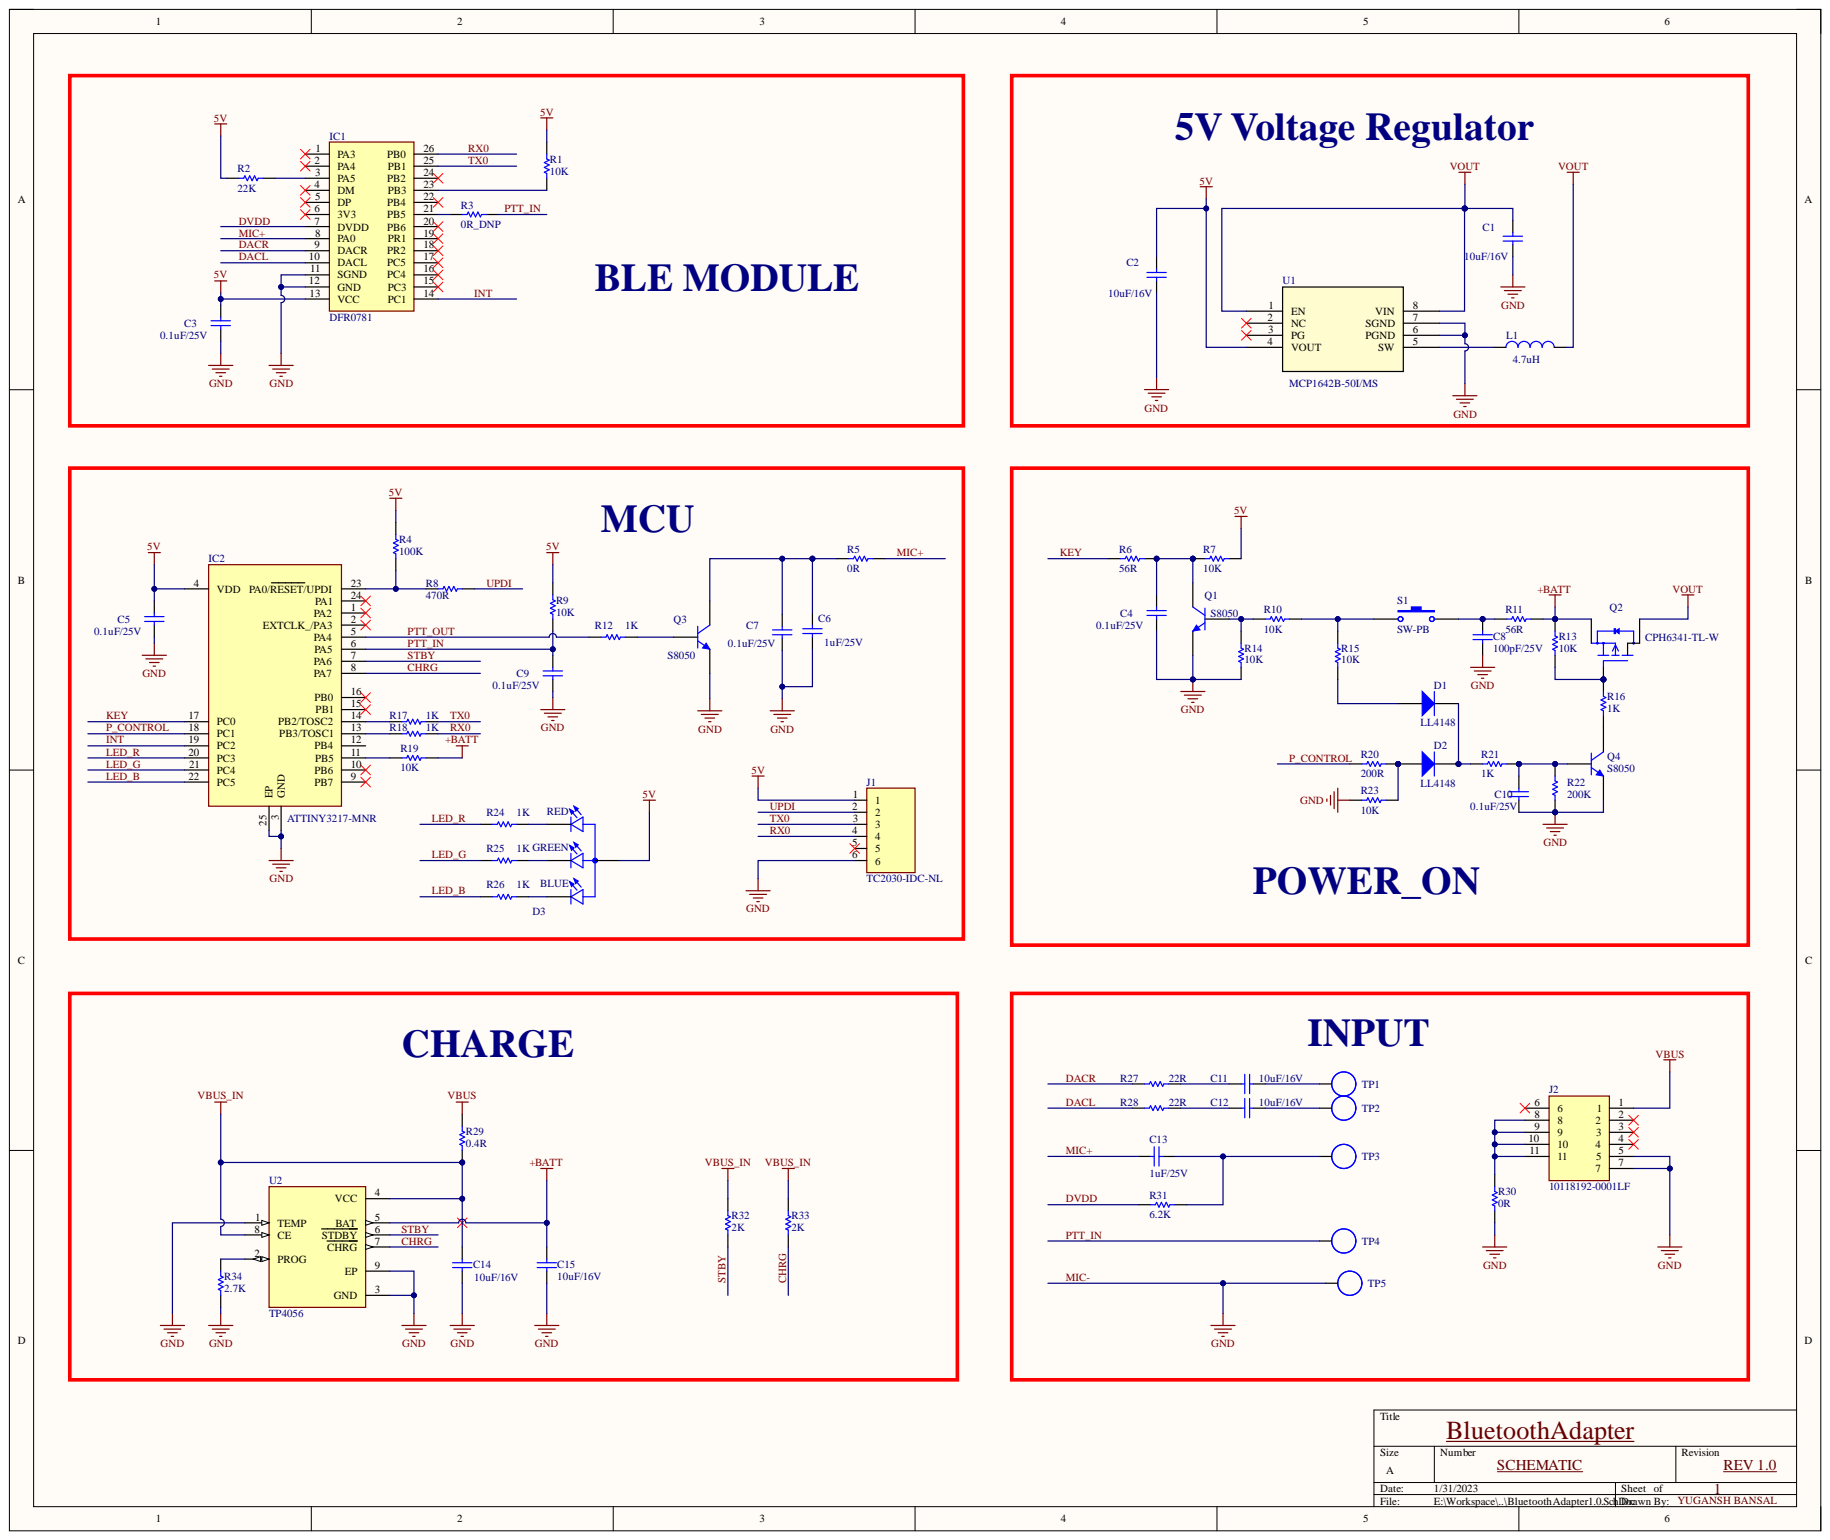
[picture p33: page 1]
