designmaster0928/Bluetooth-Adapter-Project/DXP/Version1_POC/Production_Files/BluetoothAdapter1.0.pdf

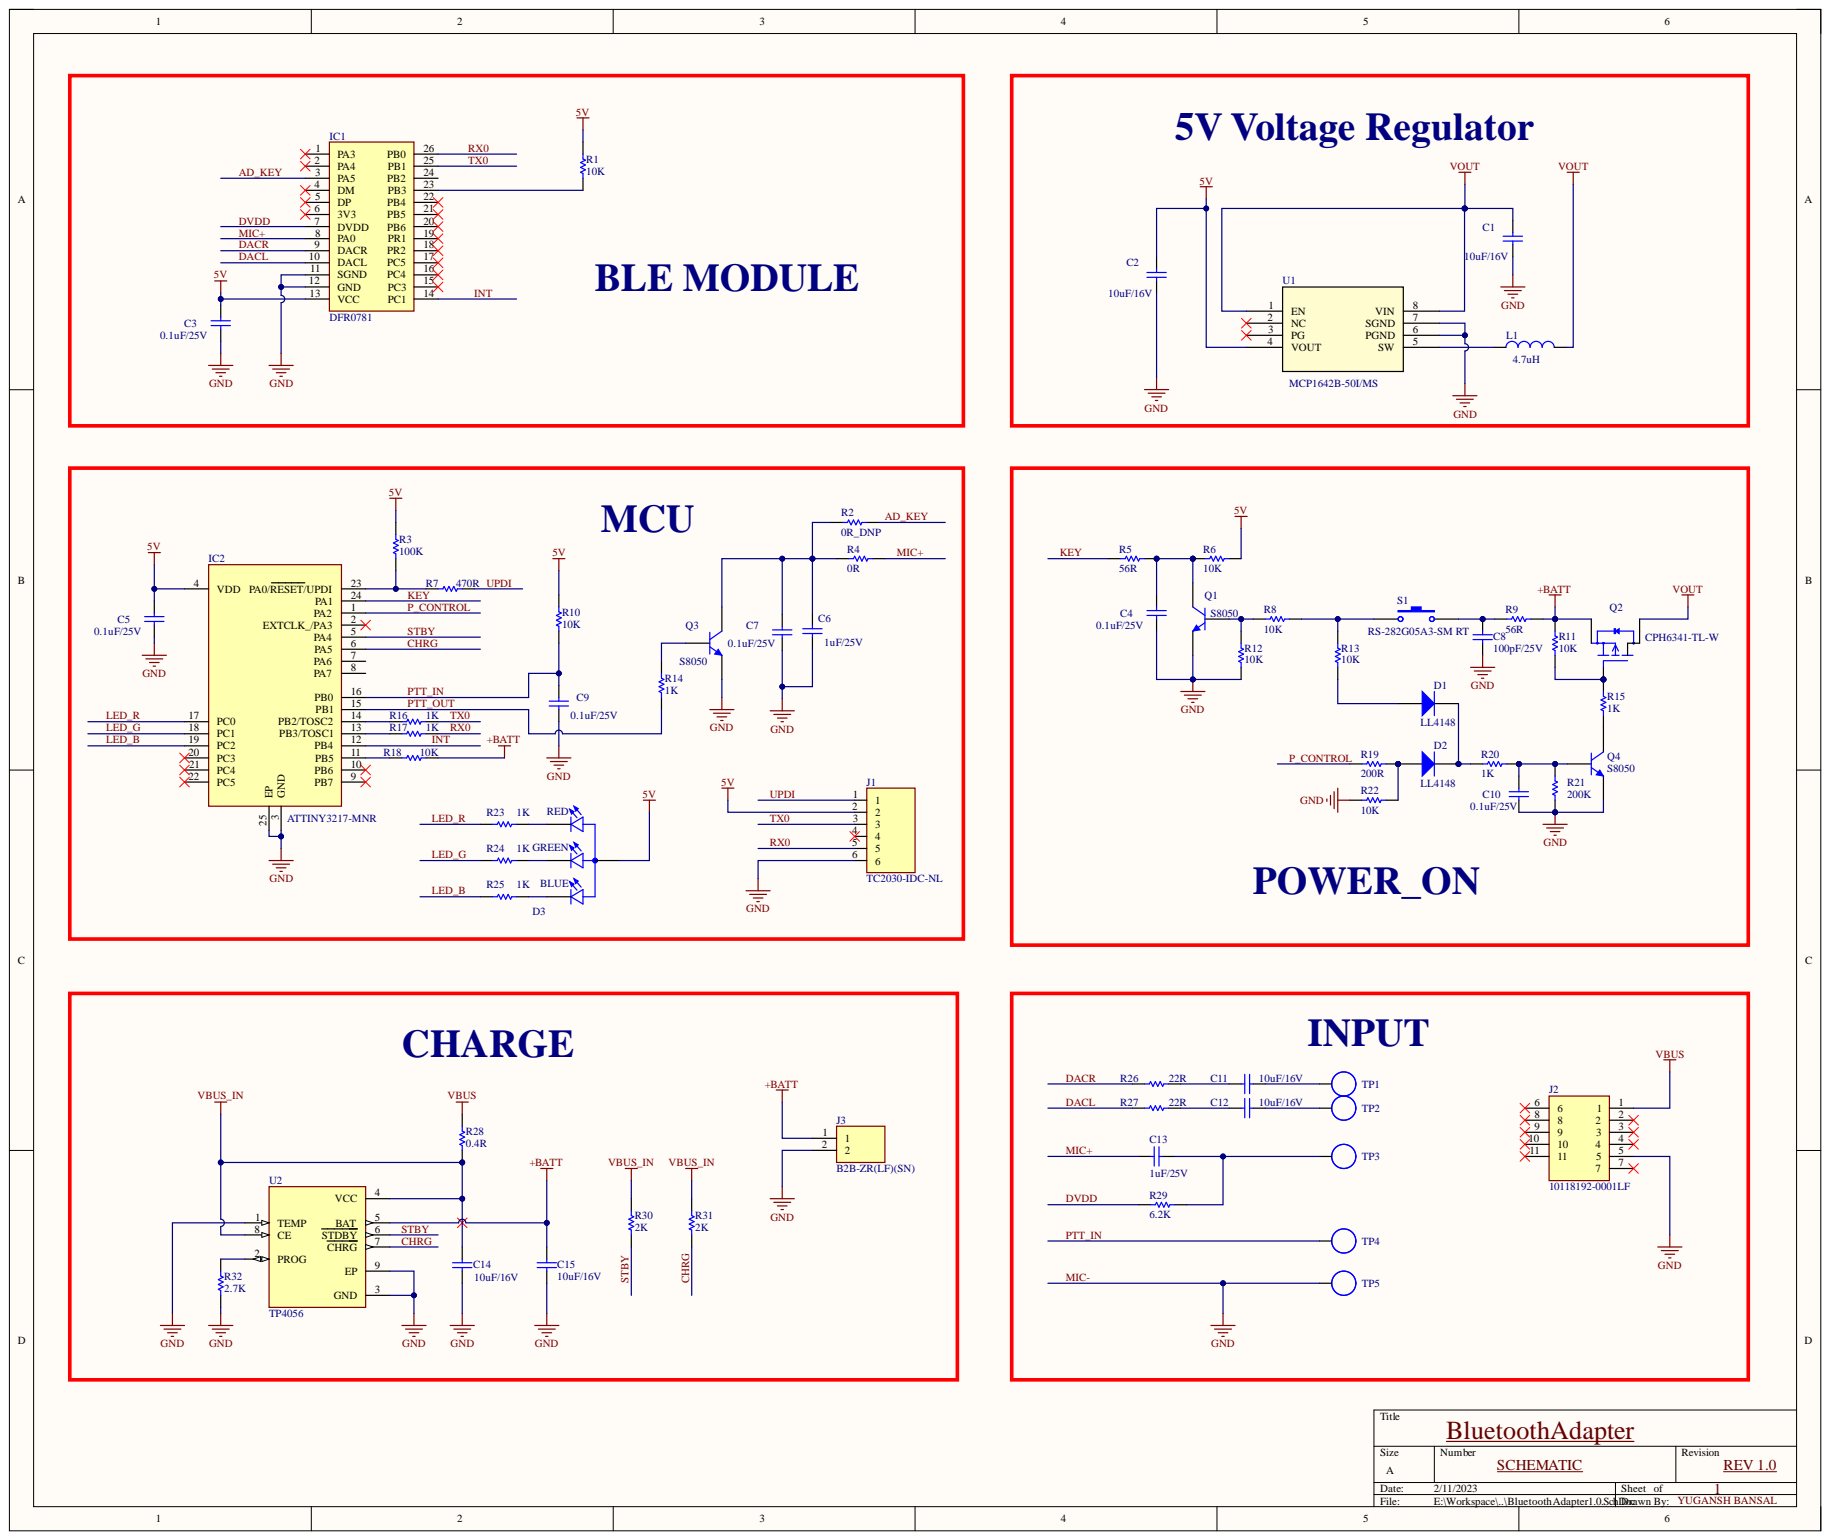
[picture p34: page 1]

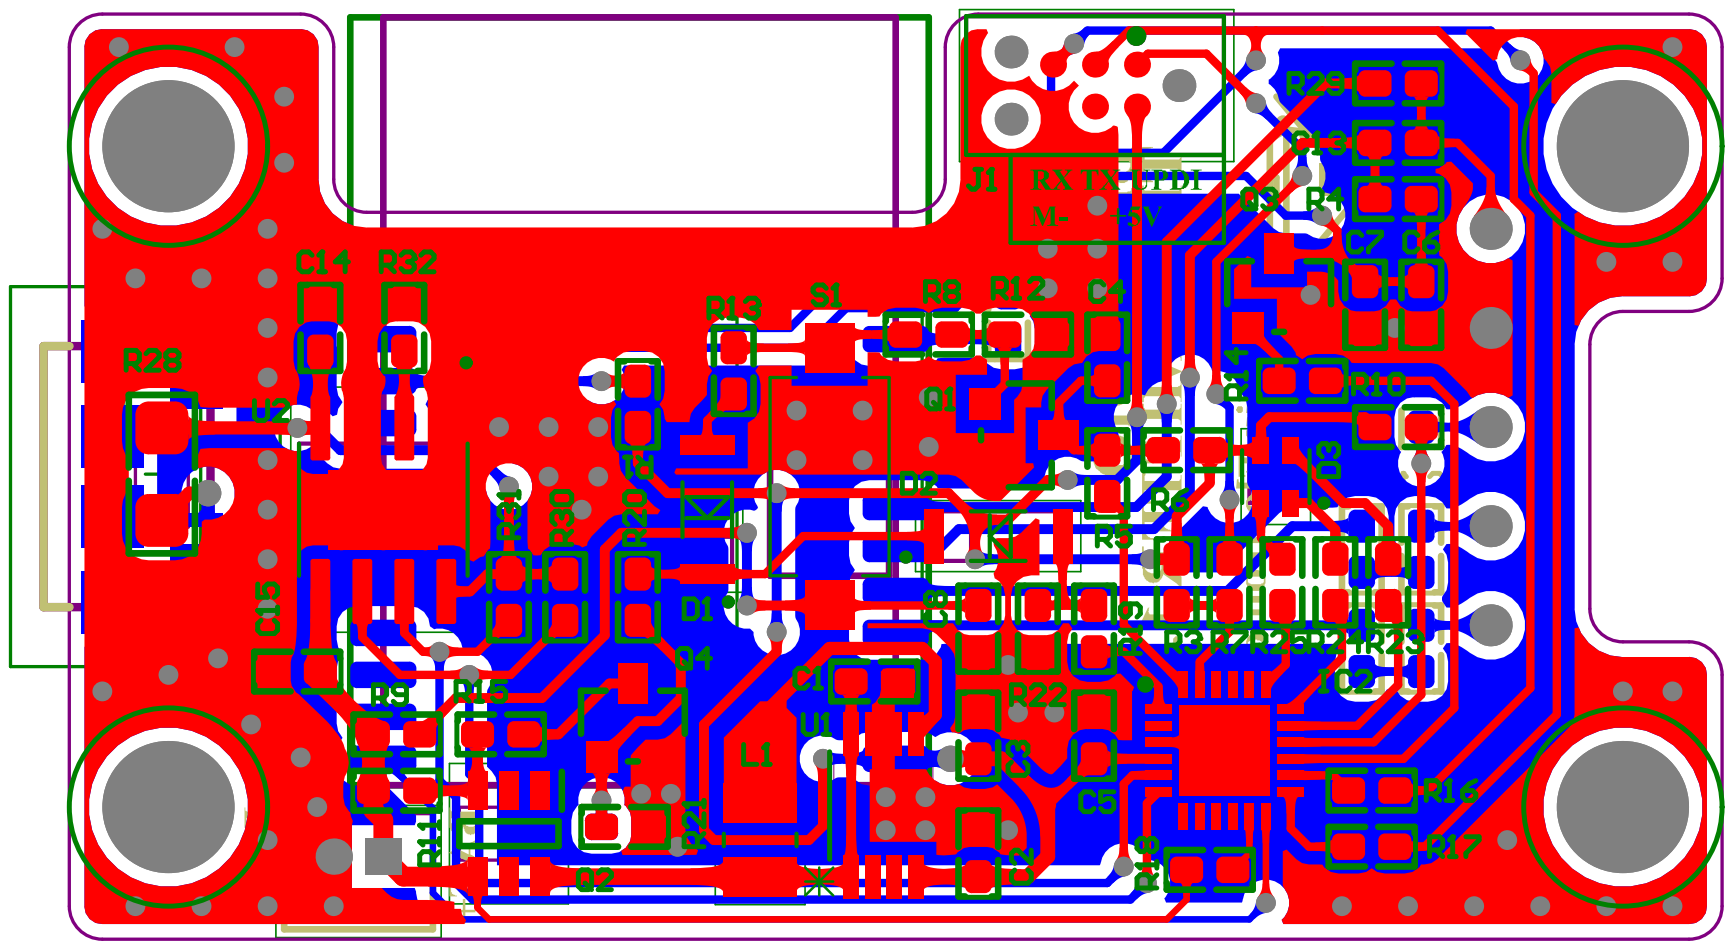
[picture p35: page 2]
