designmaster0928/Bluetooth-Adapter-Project/(list of files, drawings)

Other design files:
DXP/Version1_POC/Design_Files/BluetoothAdapter1.0.PrjPcb
DXP/Version1_POC/Design_Files/BluetoothAdapter1.0.SchDoc
DXP/version2_AA Battery/Design_Files/BluetoothAdapter2.0.PrjPcb
DXP/version2_AA Battery/Design_Files/BluetoothAdapter2.0.SchDoc
DXP/version3_LIPO/Design_Files/BluetoothAdapter3.0.PrjPcb
DXP/version3_LIPO/Design_Files/BluetoothAdapter3.0.SchDoc
DXP/version4_LIPO/Design_Files/BluetoothAdapter4.0.PrjPcb
DXP/version4_LIPO/Design_Files/BluetoothAdapter4.0.SchDoc
