designmaster0928/Bluetooth-Adapter-Project/firmware/New folder/BLEthAdapter/DFRobot_BT401.cpp

/*!
 * @file DFRobot_BT401.cpp
 * @brief Define the basic structure of DFRobot_BT401 class and the implementation of underlying methods
 * @copyright   Copyright (c) 2010 DFRobot Co.Ltd (http://www.dfrobot.com)
 * @License     The MIT License (MIT)
 * @author [Eddard](eddard.liu@dfrobot.com)
 * @version  V1.0
 * @date  2020-12-29
 * @url https://github.com/DFRobot/DFRobot_BT401
 */

#include "DFRobot_BT401.h"
#include <Arduino.h>
#include <string.h>
#include <stdio.h>


DFRobot_BT401::DFRobot_BT401() {
}

bool DFRobot_BT401::begin(Stream &s) {
  _s = &s;
  if (_s == NULL) {
    return false;
  }
  return true;
}

bool DFRobot_BT401::setVOl(uint8_t vol) {
  char data[2];
  DBG("\r\n");
  itoa(vol, data, 10);
  DBG("\r\n");
  if (vol > 9) {
    sendCMD("CA", data);
  } else {
    sendCMD("CA0", data);
  }
  DBG("\r\n");
  if (readAck() == "OK\r\n") {
    DBG("true\r\n");
    return true;
  } else {
    DBG("false\r\n");
    return false;
  }
}

bool DFRobot_BT401::switchFunction(eFunction_t function) {
  char data[1];
  DBG("\r\n");
  itoa(function, data, 10);
  DBG("\r\n");
  sendCMD("CM0", data);
  DBG("\r\n");
  if (readAck() == "OK\r\n") {
    DBG("true\r\n");
    return true;
  } else {
    DBG("false\r\n");
    return false;
  }
}

bool DFRobot_BT401::setPlayMode(ePlayMode_t mode) {
  char data[1];
  itoa(mode, data, 10);
  sendCMD("AC0", data);
  if (readAck() == "OK\r\n") {
    return true;
  } else {
    return false;
  }
}

bool DFRobot_BT401::playControl(ePlayControl_t cmd) {
  char data[1];
  itoa(cmd, data, 10);
  sendCMD("AA0", data);
  if (readAck() == "OK\r\n") {
    return true;
  } else {
    return false;
  }
}

bool DFRobot_BT401::next() {
  sendCMD("CD");
  if (readAck() == "OK\r\n") {
    return true;
  } else {
    return false;
  }
}

bool DFRobot_BT401::last() {
  sendCMD("CC");
  if (readAck() == "OK\r\n") {
    return true;
  } else {
    return false;
  }
}

bool DFRobot_BT401::playFileNum(uint16_t number) {
  char data[5];
  itoa(number, data, 10);
  sendCMD("AB", data);
  if (readAck() == "OK\r\n") {
    return true;
  } else {
    return false;
  }
}

bool DFRobot_BT401::playSpecFile(const char *path) {
  sendCMD("AF", path);
  if (readAck() == "OK\r\n") {
    return true;
  } else {
    return false;
  }
}

bool DFRobot_BT401::delCurFile() {
  sendCMD("AA08");
  if (readAck() == "OK\r\n") {
    return true;
  } else {
    return false;
  }
}

bool DFRobot_BT401::callOut(const char *phoneNumber) {
  sendCMD("BT", phoneNumber);
  if (readAck() == "OK\r\n") {
    return true;
  } else {
    return false;
  }
}

bool DFRobot_BT401::controltalk(eControltalk_t cmd) {
  char data[1];
  itoa(cmd, data, 10);
  sendCMD("BA0", data);
  if (readAck() == "OK\r\n") {
    return true;
  } else {
    return false;
  }
}
DFRobot_BT401::eBtStatus DFRobot_BT401::getBtStatus() {

  sendCMD("TS", NULL);
  String status = readAck(7);
  if (status == "TS+00\r\n") {
    return eStandby;
  } else if (status == "TS+01\r\n") {
    return eBTIdle;
  } else if (status == "TS+02\r\n") {
    return ePlaying;
  } else if (status == "TS+03\r\n") {
    return eCalling;
  } else if (status == "TS+04\r\n") {
    return eOnphone;
  }

  return eError;
}
String DFRobot_BT401::getTelNumber() {
  delay(50);
  sendCMD("TT", NULL);
  String phone = "";
  String data = readAck(0);
  for (uint8_t i = 0; i < data.length() - 3; i++) {
    phone += data[3 + i];
  }

  return phone;
}

bool DFRobot_BT401::reset() {
  sendCMD("CZ");
  DBG("\r\n");
  if (readAck() == "OK\r\n") {
    DBG("true\r\n");
    return true;
  } else {
    DBG("false\r\n");
    return false;
  }
}

void DFRobot_BT401::sendCMD(const char *cmd, const char *payload) {
  String data = "";
  DBG("\r\n");
  data += "AT+";
  DBG("\r\n");
  data += cmd;
  DBG("\r\n");
  if (payload != NULL)
    data += payload;
  data += "\r\n";
  DBG("\r\n");
  uint8_t length = data.length();
  DBG("\r\n");
  uint8_t at[20];

  DBG("\r\n");
  while (_s->available()) {
    DBG("\r\n");
    _s->read();
  }
  DBG(data);
  for (uint8_t i = 0; i < length; i++)
    at[i] = data[i];
  _s->write(at, length);
  data = "";
}

void DFRobot_BT401::sendCMD(const char *cmd) {
  String data;
  data = "AT+";
  data += cmd;
  data += "\r\n";
  uint8_t length = data.length();
  uint8_t at[20];
  while (_s->available()) {
    _s->read();
  }
  for (uint8_t i = 0; i < length; i++)
    at[i] = data[i];
  _s->write(at, length);
}

void DFRobot_BT401::sendData(String data) {

  uint8_t length = data.length();
  uint8_t at[10];
  while (_s->available()) {
    _s->read();
  }
  for (uint8_t i = 0; i < length; i++)
    at[i] = data[i];
  _s->write(at, length);
}


String DFRobot_BT401::readAck(uint8_t len) {
  String str = "                             ";
  size_t offset = 0, left = len;
  long long curr = millis();
  if (len == 0) {
    while (1) {
      if (_s->available()) {
        str[offset] = _s->read();
        left--;
        offset++;
      }
      if (str[offset - 1] == '\n' && str[offset - 2] == '\r') break;
      if (millis() - curr > 1000) {
        return "error";
        break;
      }
    }
  } else {
    while (left) {
      DBG(left);
      if (_s->available()) {
        str[offset] = _s->read();
        left--;
        DBG(str[offset]);
        offset++;
      }
      if (millis() - curr > 1000) {
        return "error";
      }
    }
    str[len] = 0;
  }
  DBG(str);
  delay(1);
  return str;
}
String DFRobot_BT401::QueryName() {
  String str = "                             ";
  size_t offset = 0;
  long long curr = millis();
  while (1) {
    if (_s->available()) {
      str[offset] = _s->read();
      offset++;
    }
    if (str[offset - 1] == '\n' && str[offset - 2] == '\r') break;
    if (millis() - curr > 1000) {
      return "error";
      break;
    }
  }
  delay(1);
  return str;
}
bool DFRobot_BT401::SppName(const char *name) {
  sendCMD("BD", name);
  if (readAck() == "OK\r\n") {
    return true;
  } else {
    return false;
  }
}
bool DFRobot_BT401::BleName(const char *name) {
  sendCMD("BM", name);
  if (readAck() == "OK\r\n") {
    return true;
  } else {
    return false;
  }
}
bool DFRobot_BT401::btPassword(const char *pass) {
  sendCMD("BE", pass);
  if (readAck() == "OK\r\n") {
    return true;
  } else {
    return false;
  }
}
bool DFRobot_BT401::btMAC(const char *addr) {
  sendCMD("BS", addr);
  if (readAck() == "OK\r\n") {
    return true;
  } else {
    return false;
  }
}
bool DFRobot_BT401::playPause() {
  sendCMD("CB");
  if (readAck() == "OK\r\n") {
    return true;
  } else {
    return false;
  }
}
bool DFRobot_BT401::bleOnOff(uint8_t vol) {
  char data[2];
  itoa(vol, data, 10);
  sendCMD("B40", data);
  if (readAck() == "OK\r\n") {
    return true;
  } else {
    return false;
  }
}
bool DFRobot_BT401::edrOnOff(uint8_t vol) {
  char data[2];
  itoa(vol, data, 10);
  sendCMD("B50", data);
  if (readAck() == "OK\r\n") {
    return true;
  } else {
    return false;
  }
}
bool DFRobot_BT401::SppStatus() {
  sendCMD("TS", NULL);
  String status = readAck(7);
  if (status == "TS+00\r\n") {  // Bluetooth has not been successfully connected, and is waiting for pairing
    return false;
  } else if (status == "TS+01\r\n") {  // Bluetooth has been successfully connected, but music has not yet been played. idle
    return true;
  } else if (status == "TS+02\r\n") {  // Playing music
    return true;
  } else if (status == "TS+03\r\n") {  // There is a call out, or a call comes in. But not answering
    return true;
  } else if (status == "TS+04\r\n") {  // Calling status, the representative has been connected
    return true;
  }
  return false;
}


bool DFRobot_BT401::BleStatus() {
  sendCMD("TL", NULL);
  String status = readAck(7);
  if (status == "TL+00\r\n") {  // BLE is in empty state
    return false;
  } else if (status == "TL+01\r\n") {  // BLE is in idle state
    return false;
  } else if (status == "TL+02\r\n") {  // BLE is in broadcast state
    return false;
  } else if (status == "TL+03\r\n") {  // BLE connection is successful
    return true;
  } else if (status == "TL+04\r\n") {  // BLE disconnect
    return false;
  } else if (status == "TL+05\r\n") {  // BLE open monitoring state
    return true;
  } else if (status == "TL+06\r\n") {  // BLE is in scanning state ‑ host BLE
    return false;
  } else if (status == "TL+07\r\n") {  // search completed ‑ host
    return false;
  }
  return false;
}
bool DFRobot_BT401::ServiceUUID(const char *name) {
  sendCMD("U0", name);
  if (readAck() == "OK\r\n") {
    return true;
  } else {
    return false;
  }
}
bool DFRobot_BT401::CharacteristicUUID(const char *name) {
  sendCMD("U2", name);
  if (readAck() == "OK\r\n") {
    return true;
  } else {
    return false;
  }
}
bool DFRobot_BT401::QueryCMD(const char *cmd) {
  String data;
  data = "AT+";
  data += cmd;
  data += "\r\n";
  uint8_t length = data.length();
  uint8_t at[20];
  while (_s->available()) {
    _s->read();
  }
  for (uint8_t i = 0; i < length; i++)
    at[i] = data[i];
  _s->write(at, length);

  if (readAck() == "OK\r\n") {
    return true;
  } else {
    return false;
  }
}
uint8_t DFRobot_BT401::BleSppStatus() {
  uint8_t blespp = 0;
  String status = "                              ";
  size_t offset = 0;
  long long curr = millis();
  while (1) {
    if (_s->available()) {
      status[offset] = _s->read();
      offset++;
    }
    if (status[offset - 1] == '\n' && status[offset - 2] == '\r') break;
    if (millis() - curr > 1000) {
      break;
    }
  }
  delay(1);

  if (status == "TS+00\r\n") {  // Bluetooth has not been successfully connected, and is waiting for pairing
    temp &= 0b00000010;
  } else if (status == "TS+01\r\n") {  // Bluetooth has been successfully connected, but music has not yet been played. idle
    temp |= 0b00000001;
  } else if (status == "TS+02\r\n") {  // Playing music
    temp |= 0b00000001;
  } else if (status == "TS+03\r\n") {  // There is a call out, or a call comes in. But not answering
    temp |= 0b00000001;
  } else if (status == "TS+04\r\n") {  // Calling status, the representative has been connected
    temp |= 0b00000001;
  }

  else if (status == "TL+00\r\n") {  // BLE is in empty state
    temp &= 0b00000001;
  } else if (status == "TL+01\r\n") {  // BLE is in idle state
    temp &= 0b00000001;
  } else if (status == "TL+02\r\n") {  // BLE is in broadcast state
    temp &= 0b00000001;
  } else if (status == "TL+03\r\n") {  // BLE connection is successful
    temp |= 0b00000010;
  } else if (status == "TL+04\r\n") {  // BLE disconnect
    temp &= 0b00000001;
  } else if (status == "TL+05\r\n") {  // BLE open monitoring state
    temp |= 0b00000010;
  } else if (status == "TL+06\r\n") {  // BLE is in scanning state ‑ host BLE
    temp &= 0b00000001;
  } else if (status == "TL+07\r\n") {  // search completed ‑ host
    temp &= 0b00000001;
  }

  blespp = temp;

  return blespp;
}
